kerikun11/micromouse-kerise-v6/README.md

# MicroMouse KERISE v6

けりの第6作目マイクロマウス

## 回路設計

- KiCad

## 機体設計

- Fusion 360

## ソフトウェア開発

- PlatformIO Espressif32 ESP-IDF
