kerikun11/micromouse-kerise-v6/kicad/KERISE.pdf

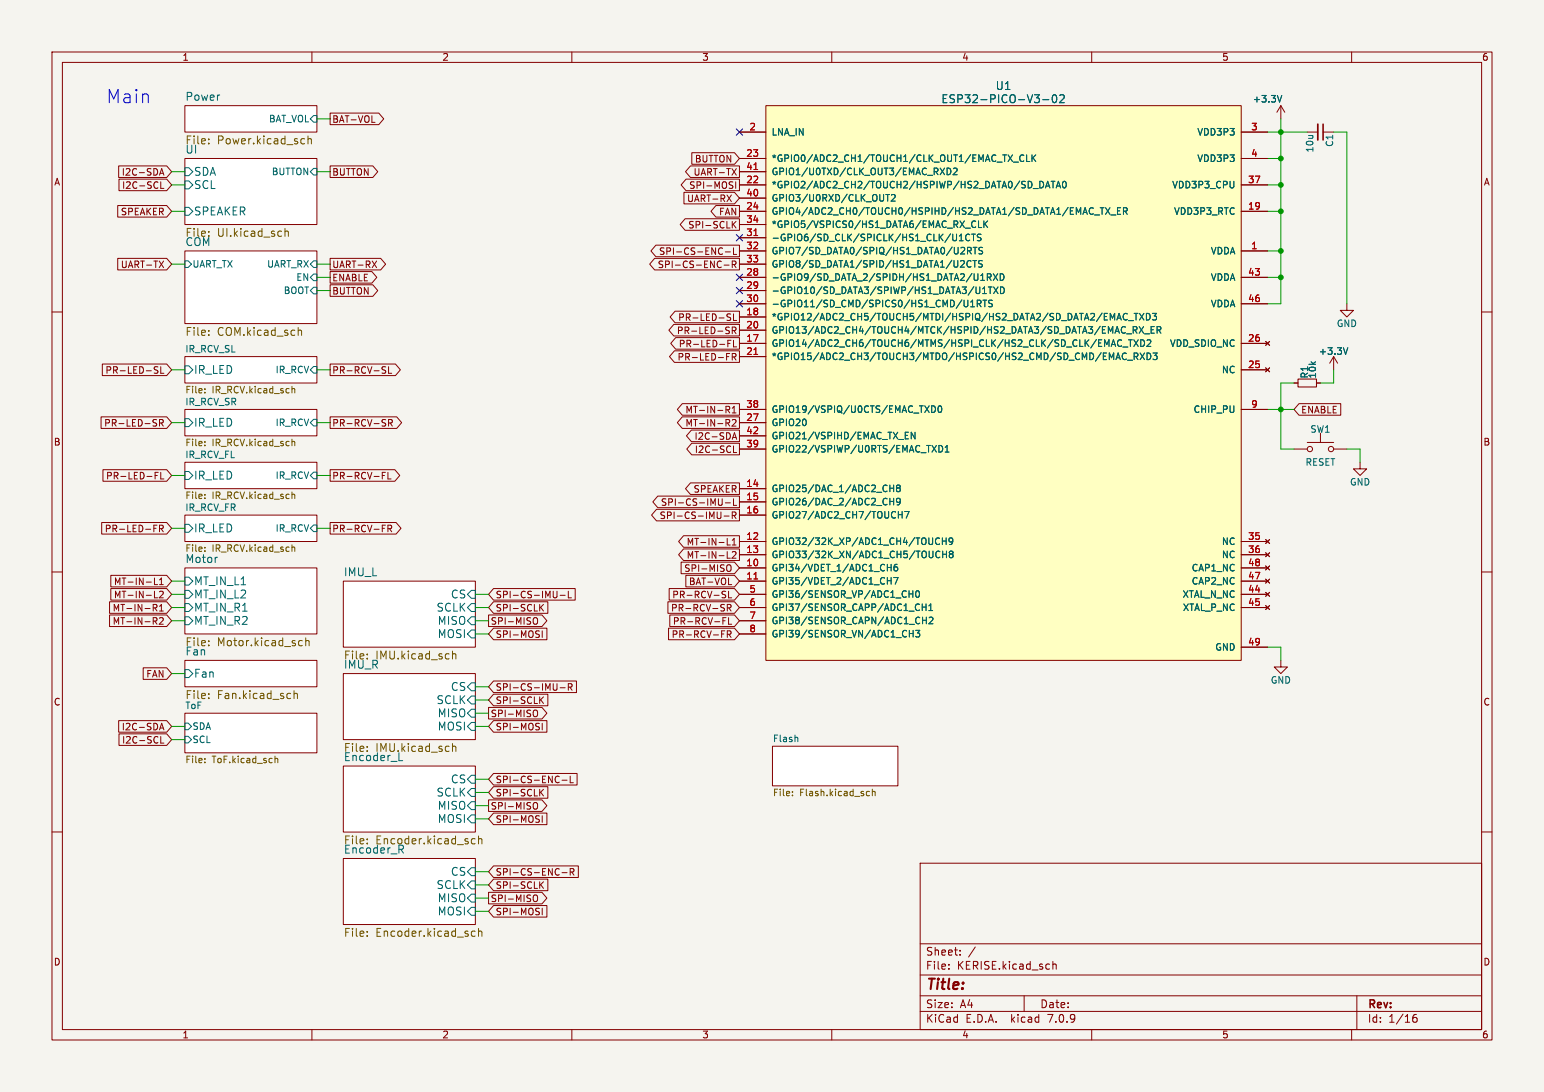
[picture p1: page 1]

PR-RCV-SL PR-RCV-FR MT-IN-R1 UART-RX

SDA UI File: UI.kicad_sch

FAN
PR-RCV-FL PR-LED-SR MT-IN-R2 SPI-CS-IMU-R
PR-LED-FL MT-IN-L2 BAT-VOL MT-IN-L1 SPI-MISO
PR-LED-FR

PR-RCV-FL PR-RCV-SL PR-RCV-SR

PR-LED-SL FAN

SPI-CS-IMU-L SPI-CS-ENC-L SPI-SCLK

MOSI
Flash File: Flash.kicad_sch CS

Id: 1/16 Title: File: KERISE.kicad_sch Sheet: / CS
SCLK
MISO

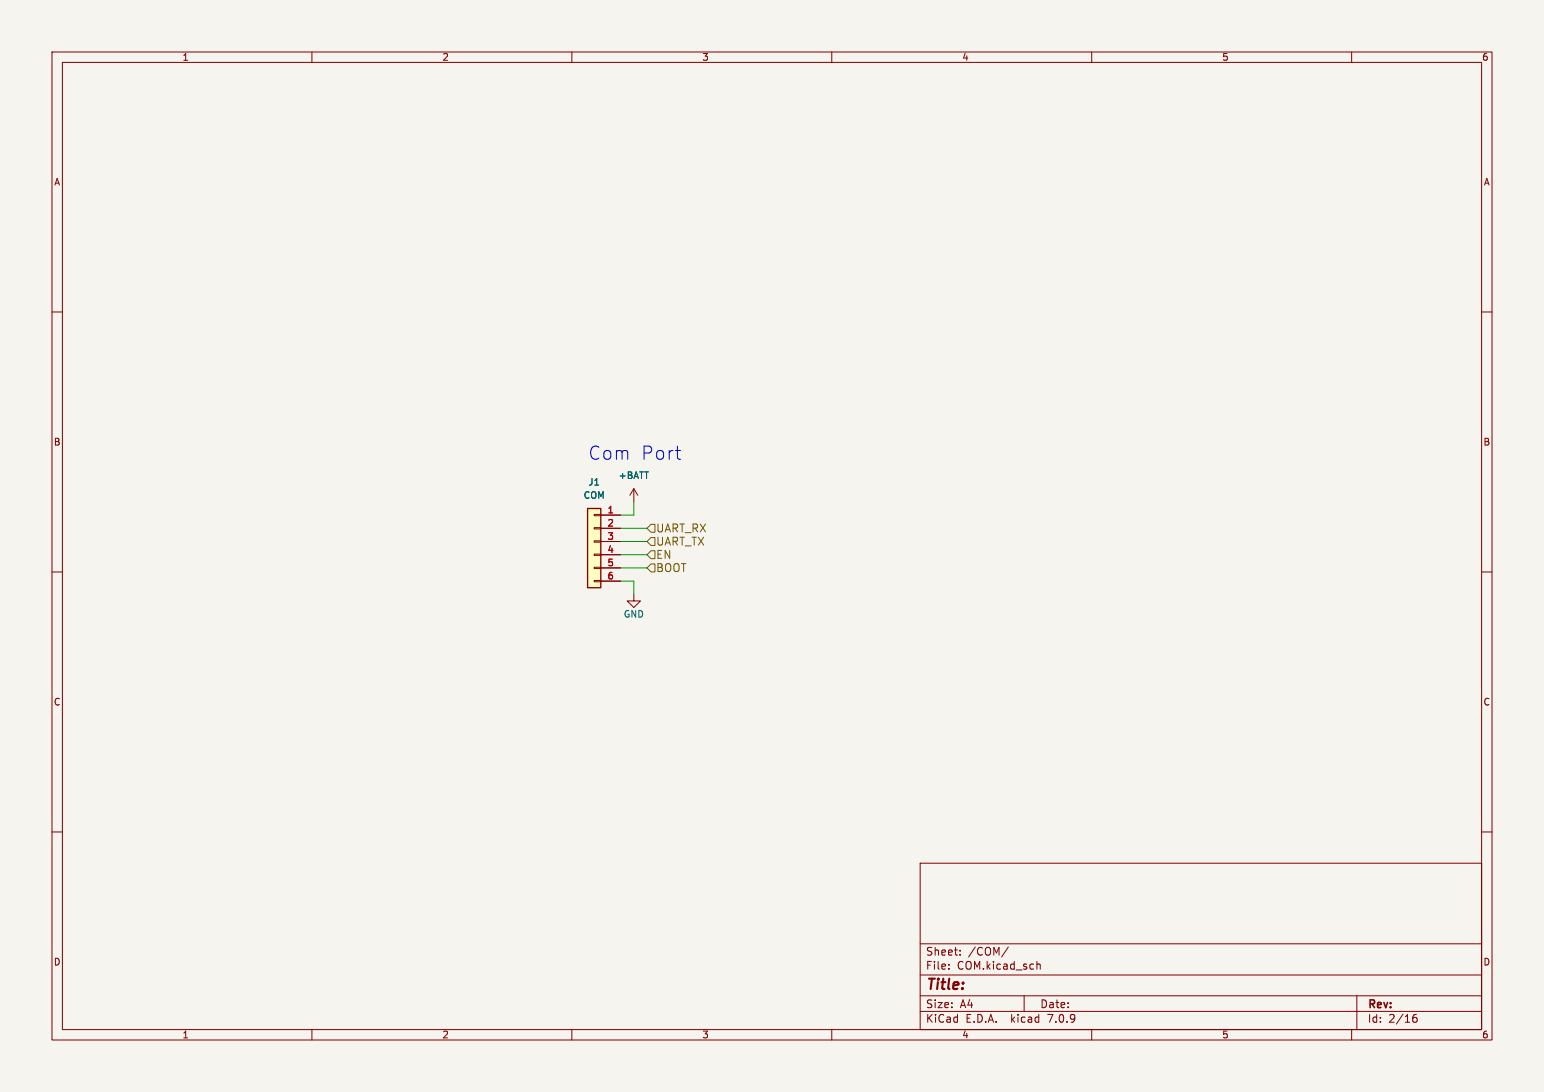
[picture p2: page 2]

Id: 2/16 Title: File: COM.kicad_sch Sheet: /COM/ GND

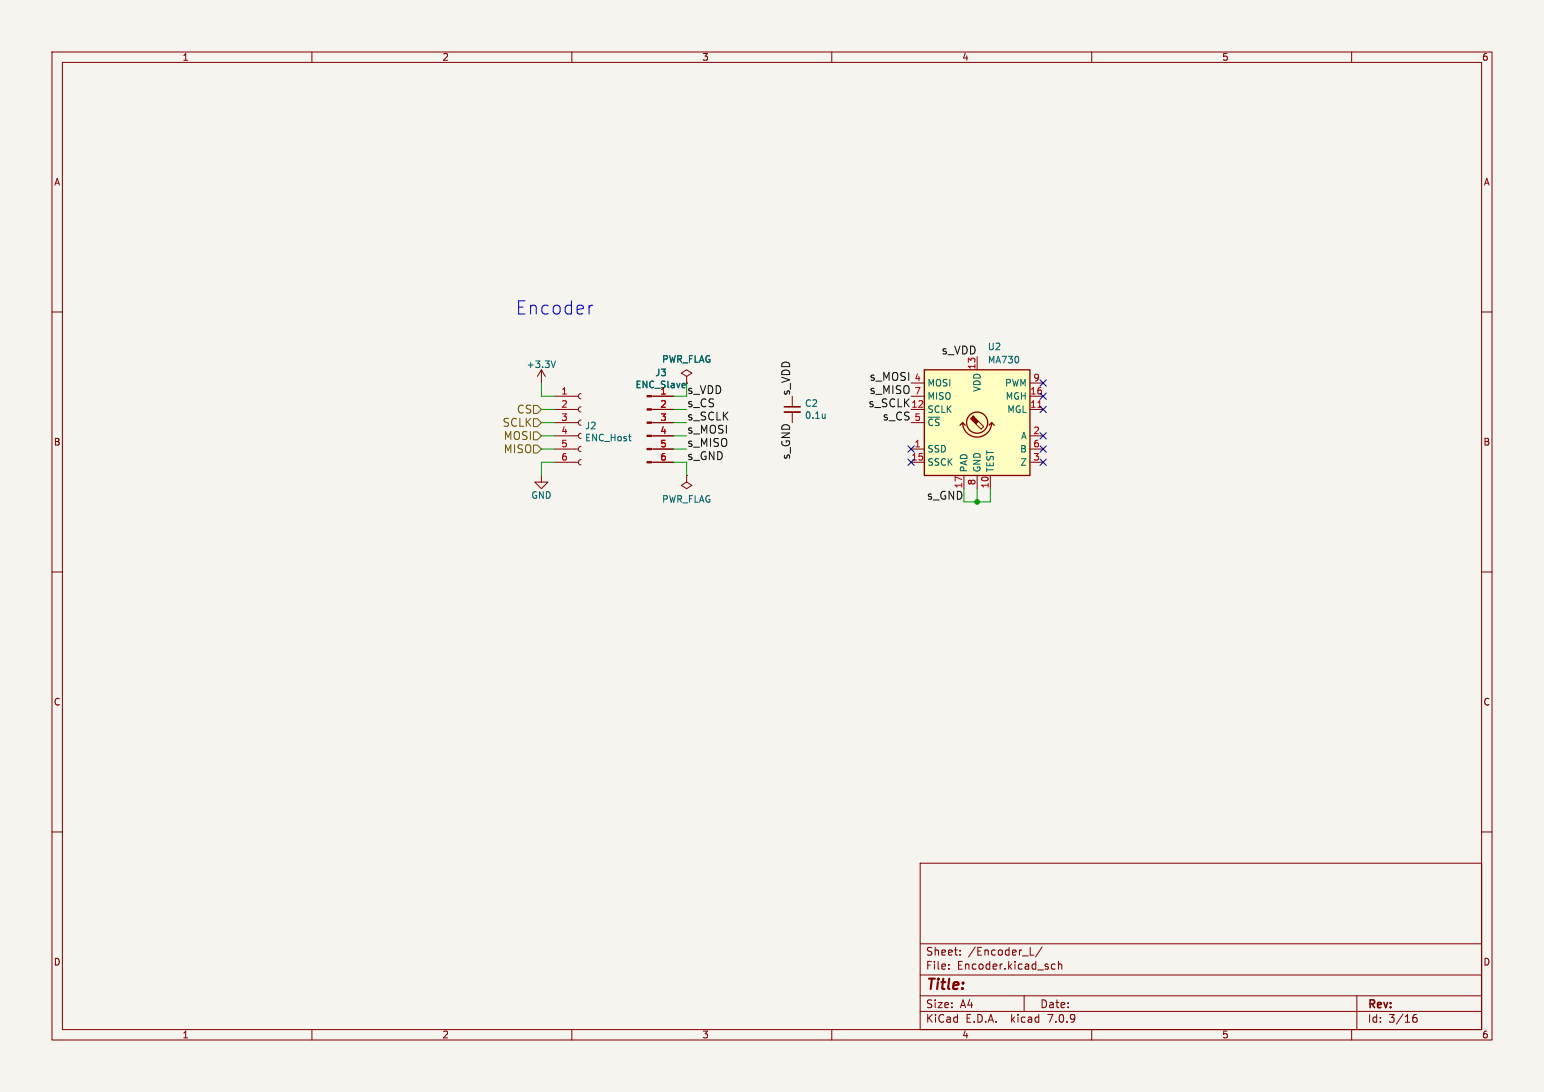
[picture p3: page 3]

Id: 3/16 Title: File: Encoder.kicad_sch Sheet: /Encoder_L/ GND

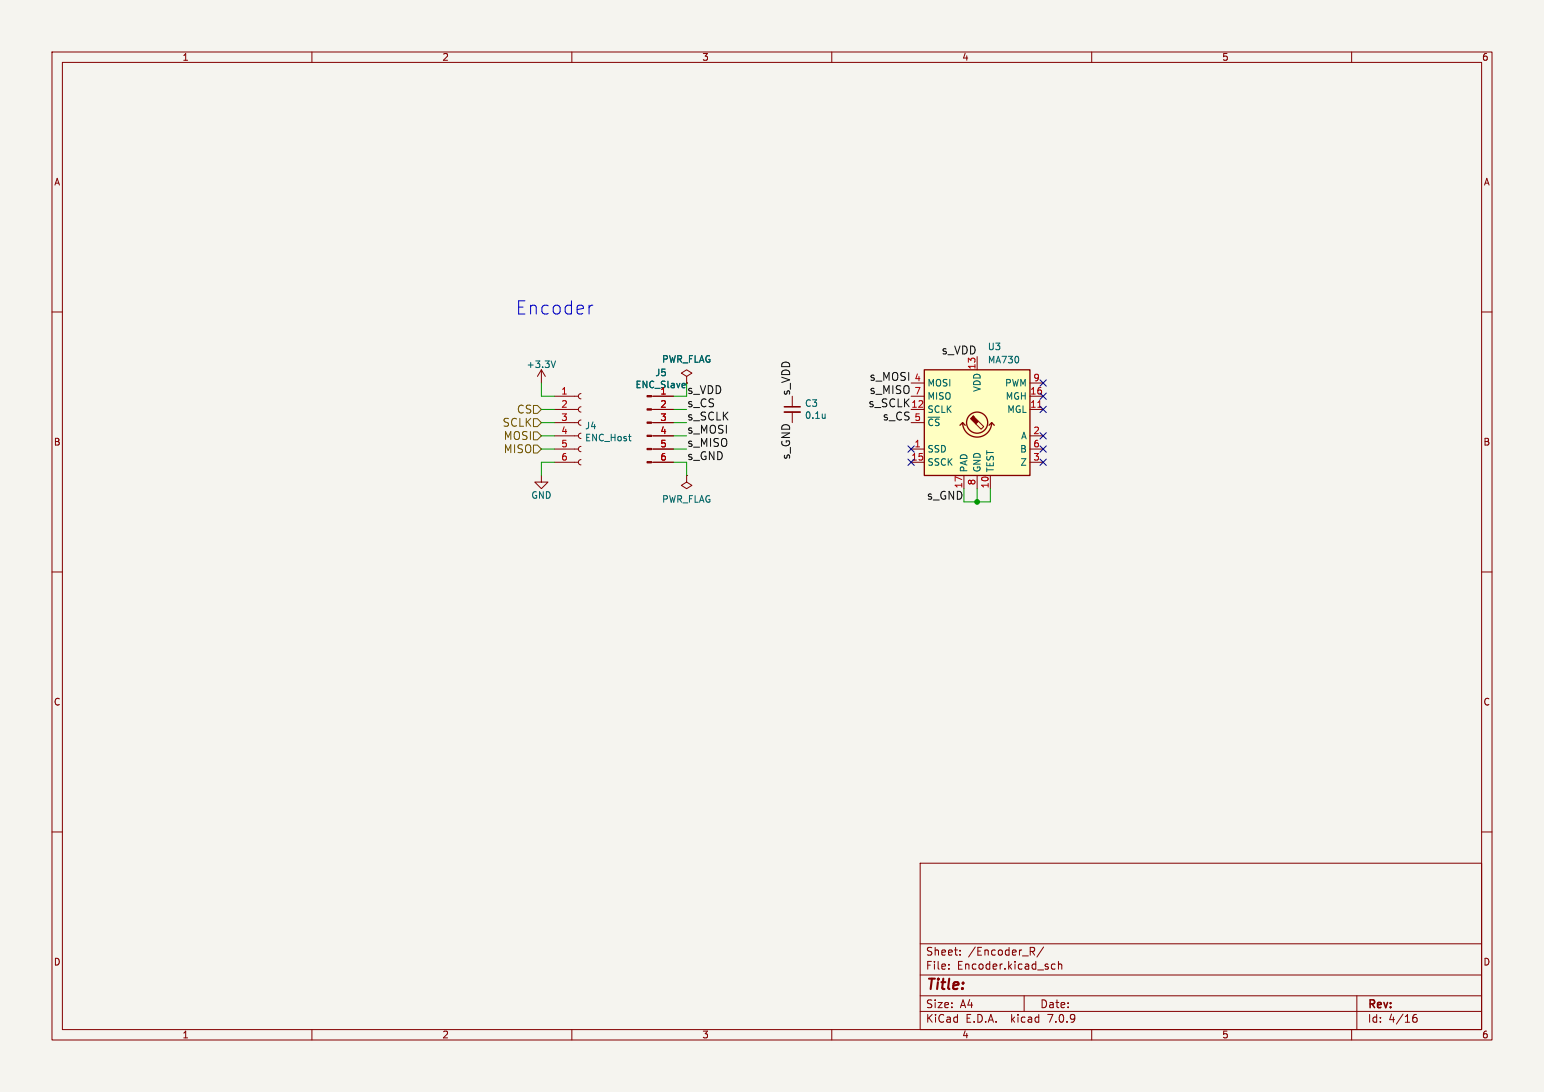
[picture p4: page 4]

Id: 4/16 Title: File: Encoder.kicad_sch Sheet: /Encoder_R/ GND

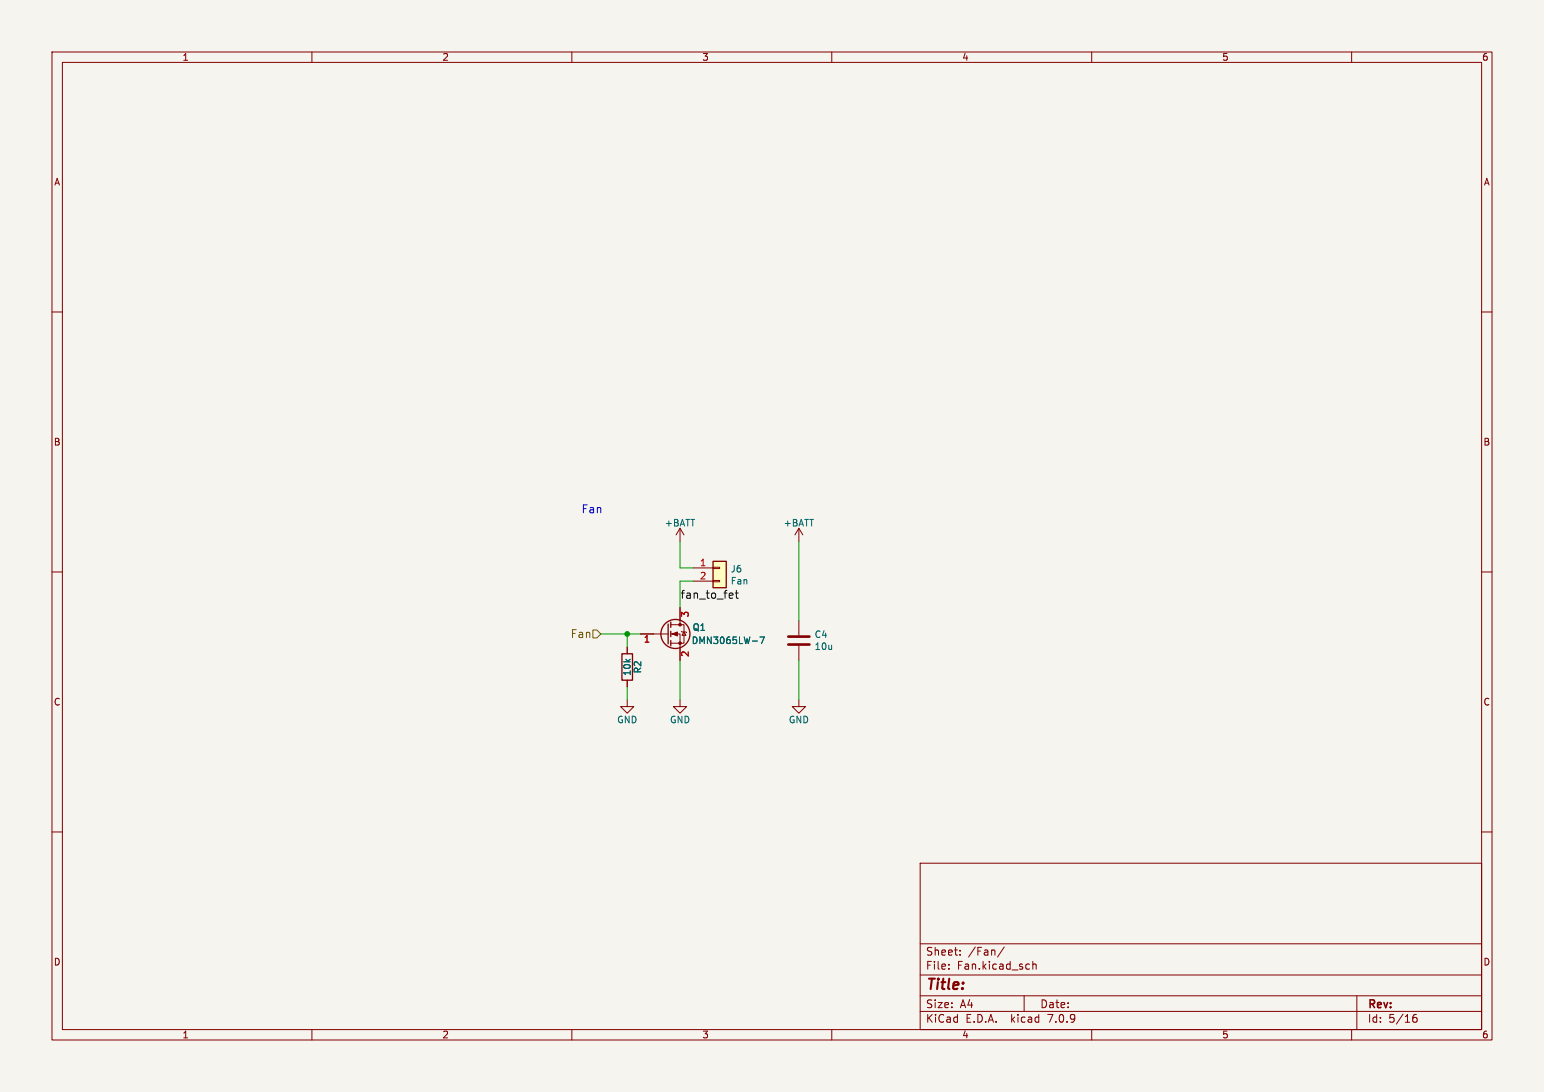
[picture p5: page 5]

2 3 Q1 DMN3065LW-7 C4
Id: 5/16 Title: File: Fan.kicad_sch Sheet: /Fan/ 1

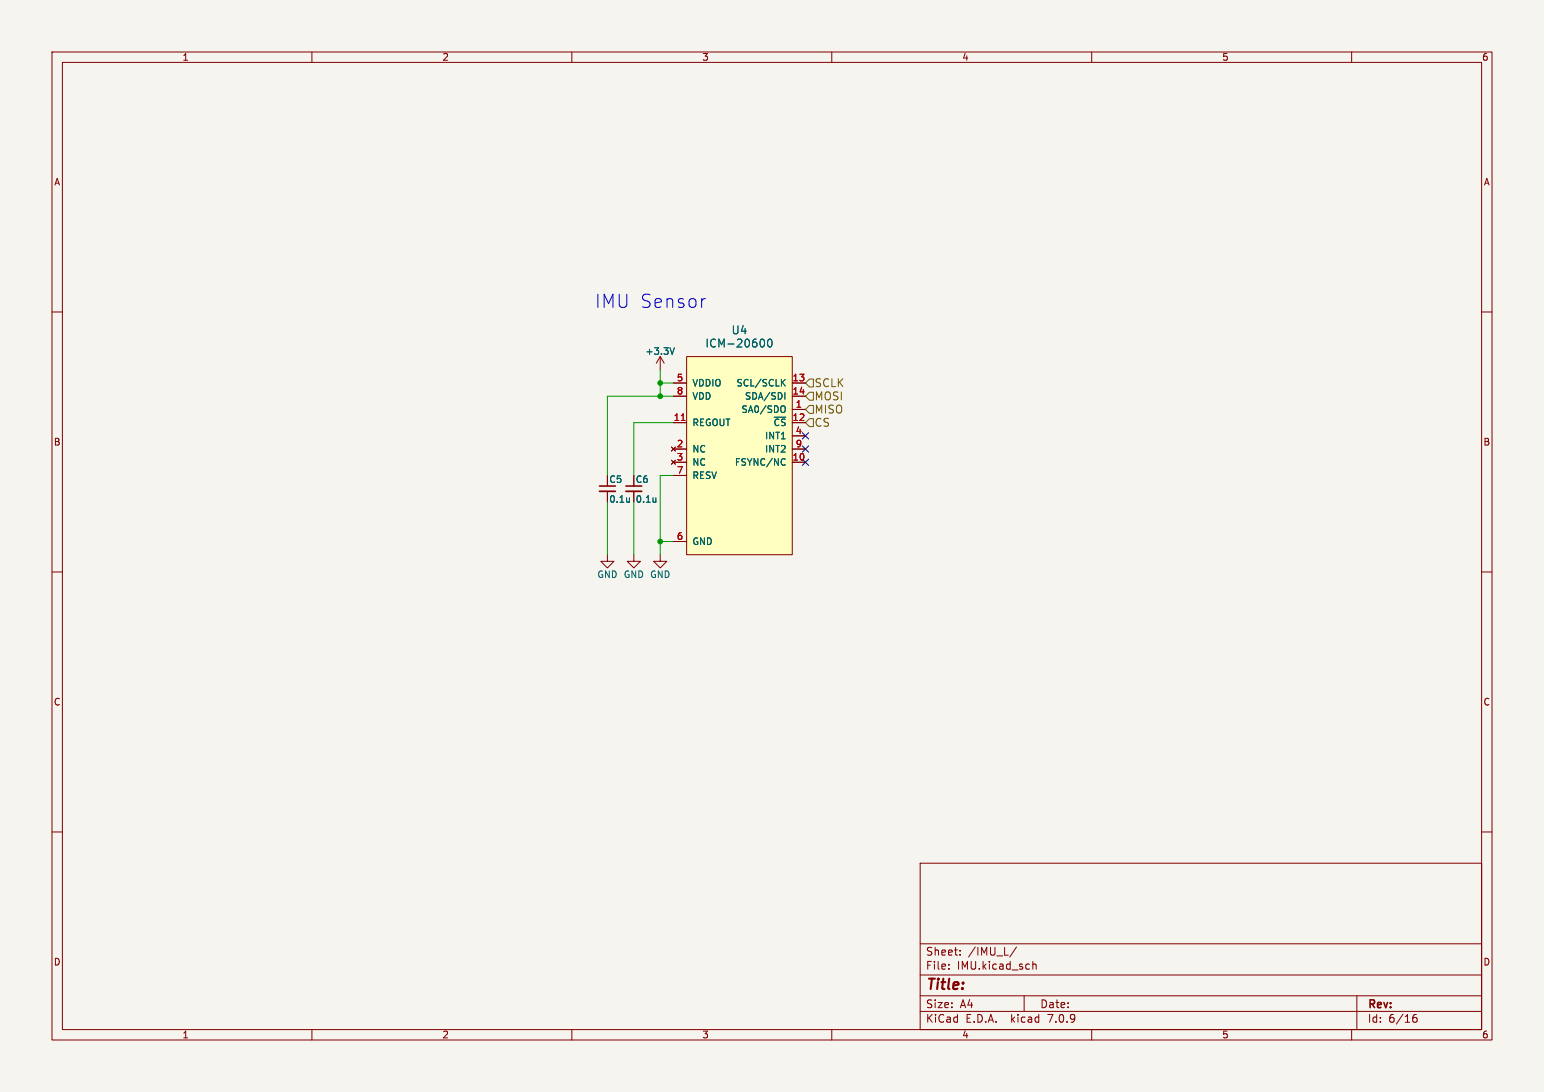
[picture p6: page 6]

Id: 6/16 Title: File: IMU.kicad_sch Sheet: /IMU_L/

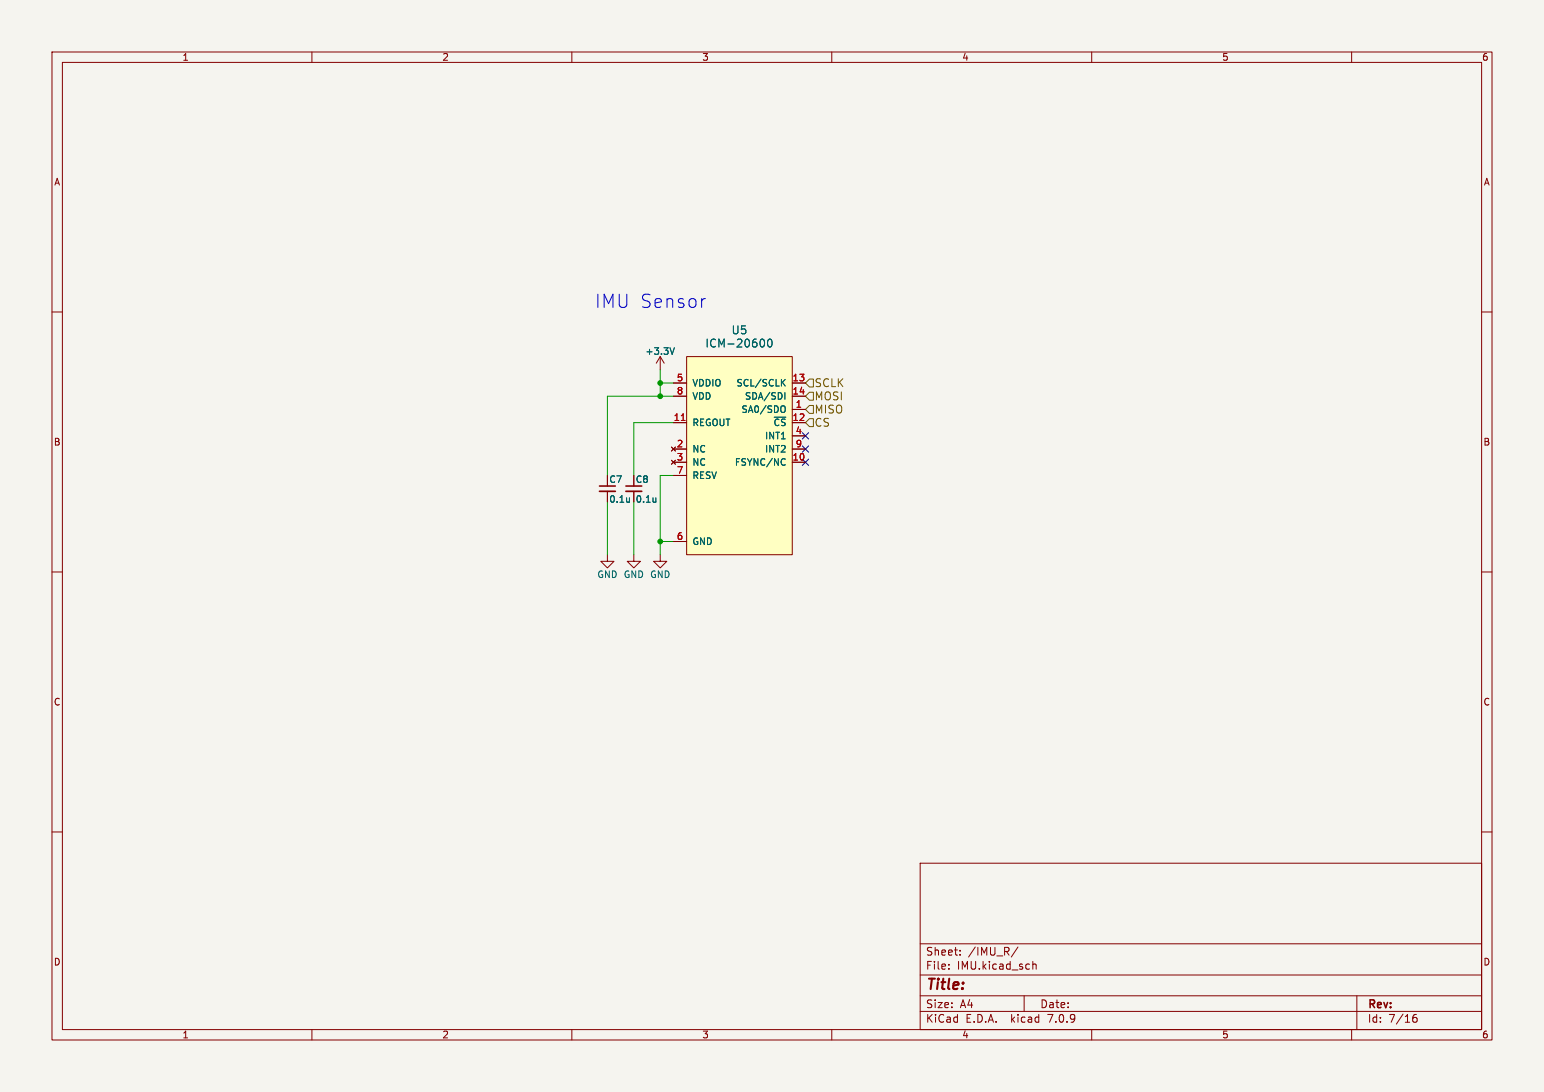
[picture p7: page 7]

Id: 7/16 Title: File: IMU.kicad_sch Sheet: /IMU_R/

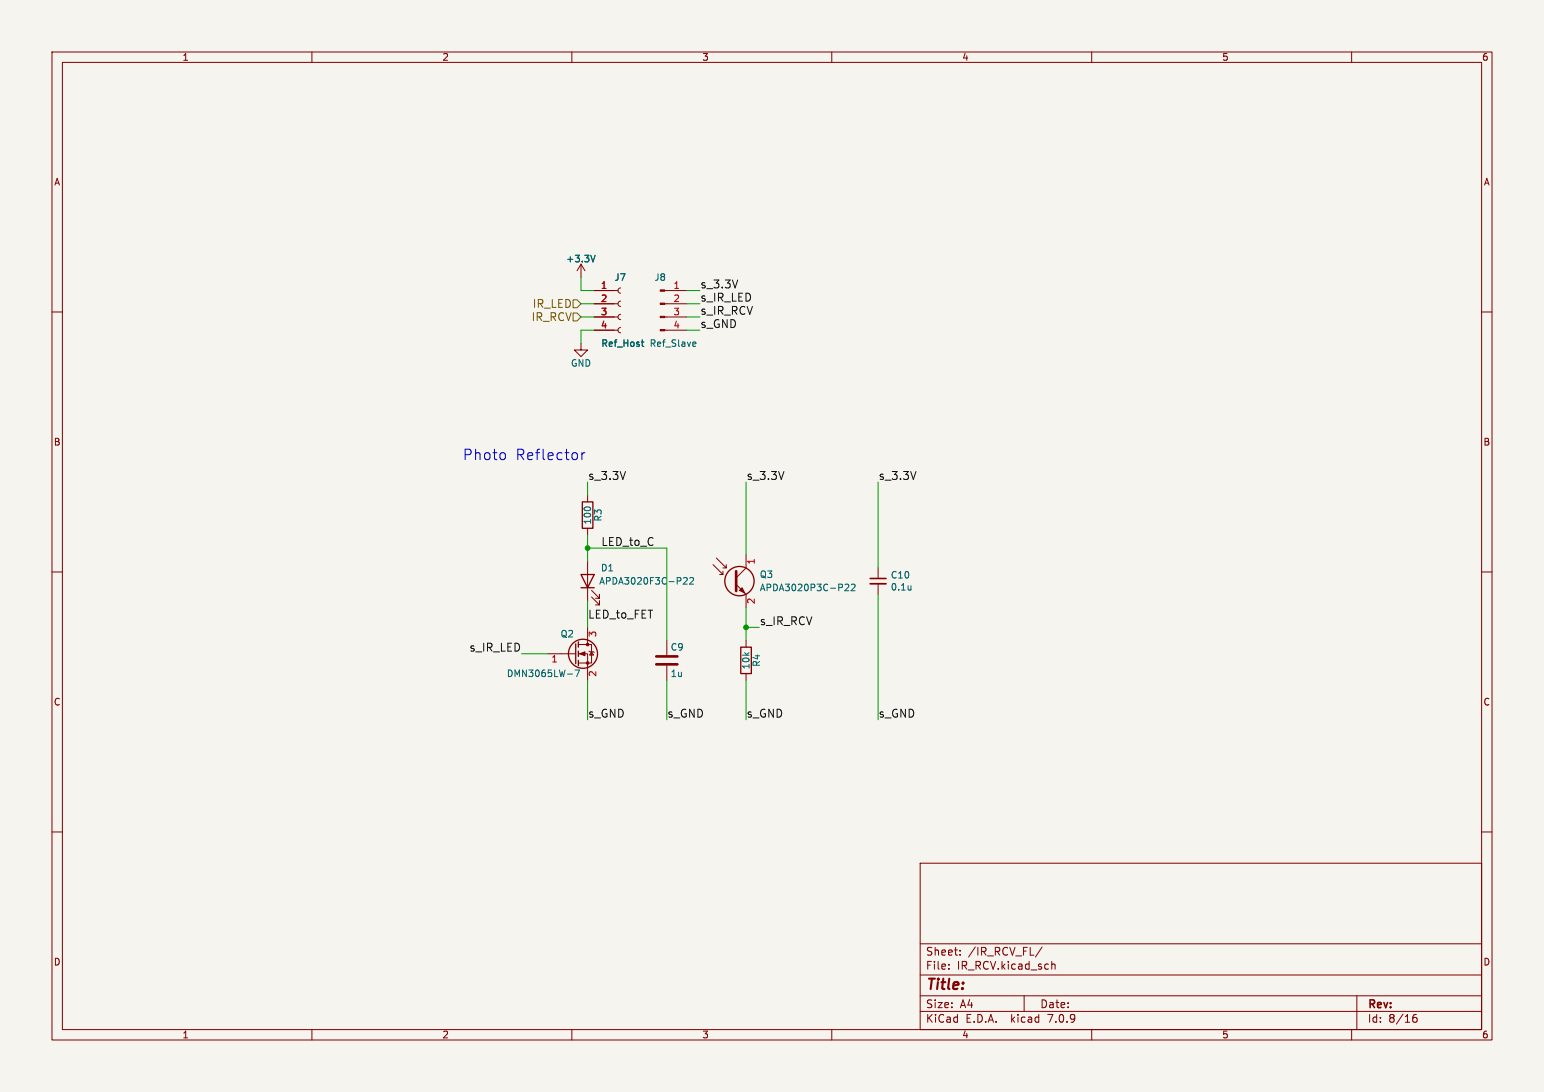
[picture p8: page 8]

Id: 8/16 Title: File: IR_RCV.kicad_sch Sheet: /IR_RCV_FL/ C10

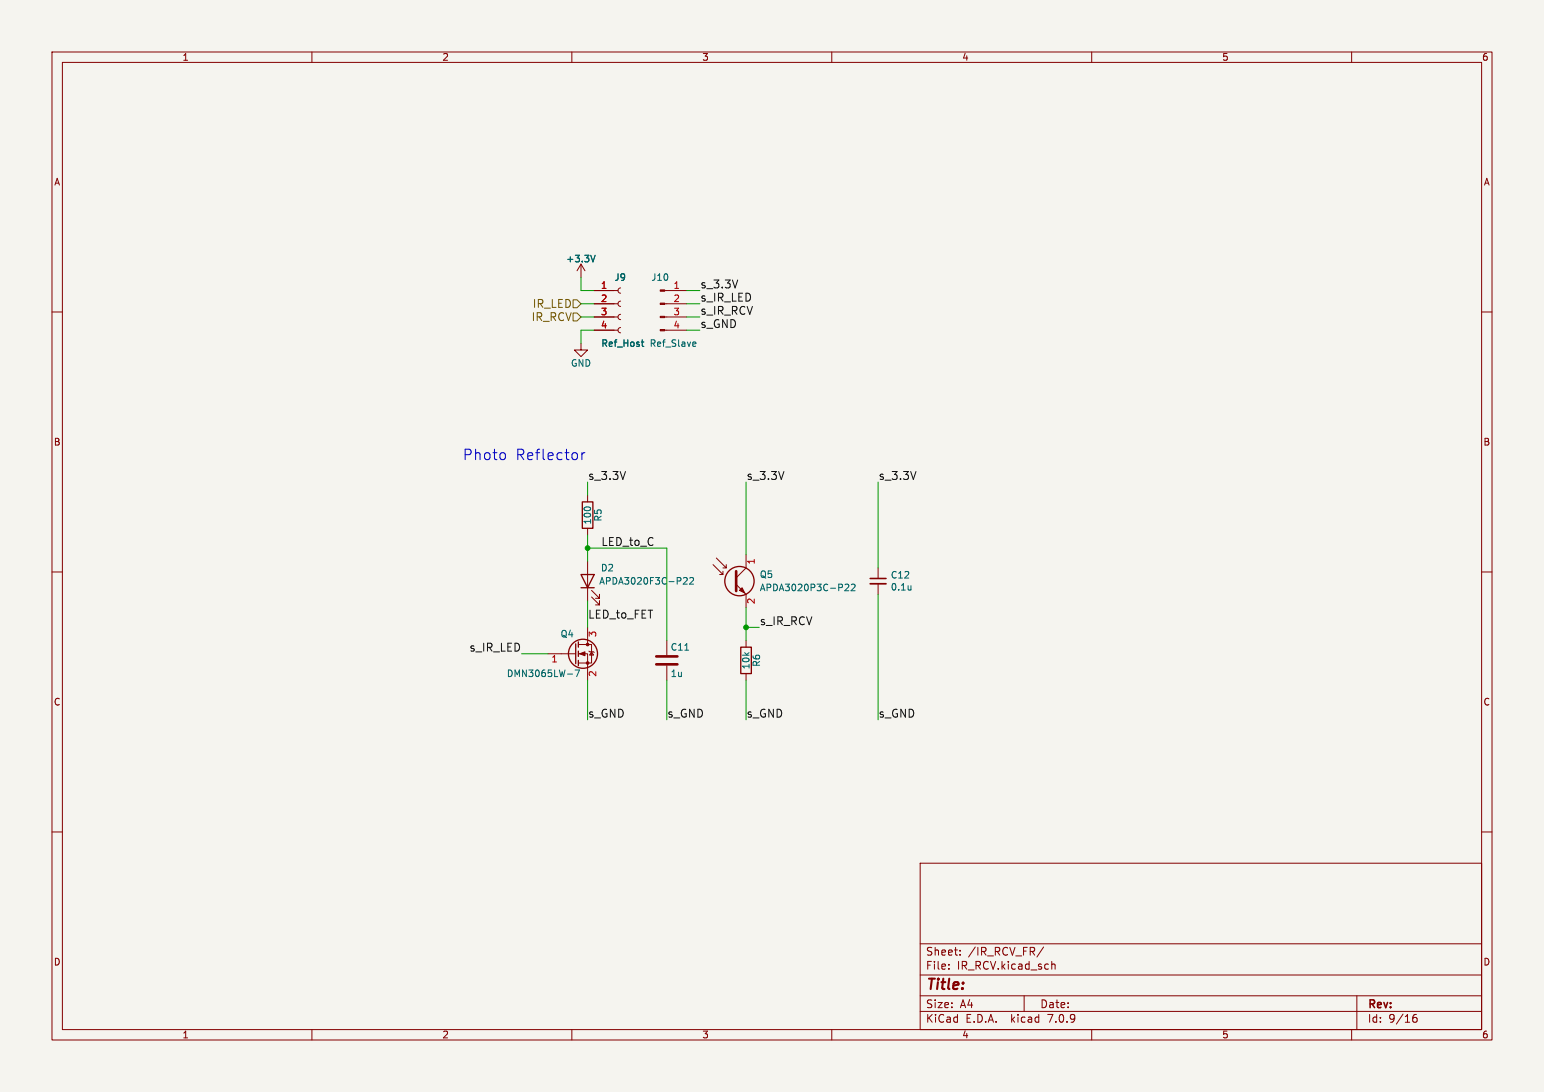
[picture p9: page 9]

Id: 9/16 Title: File: IR_RCV.kicad_sch Sheet: /IR_RCV_FR/ C12

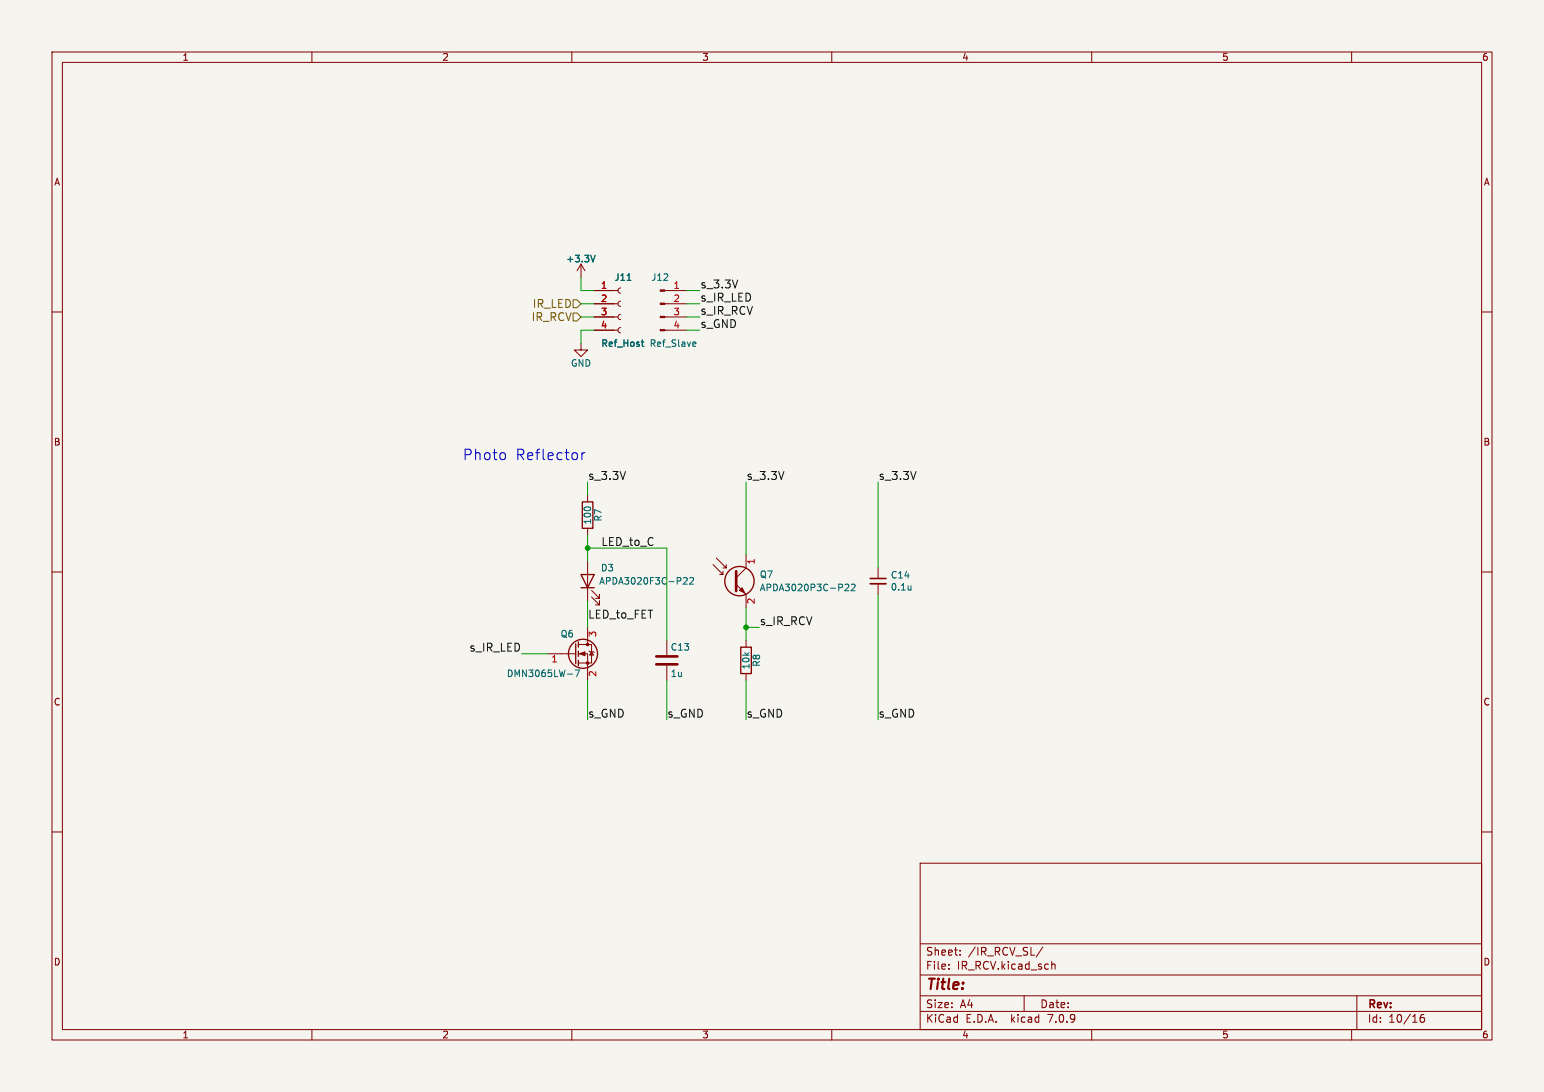
[picture p10: page 10]

Id: 10/16 Title: File: IR_RCV.kicad_sch Sheet: /IR_RCV_SL/ C14

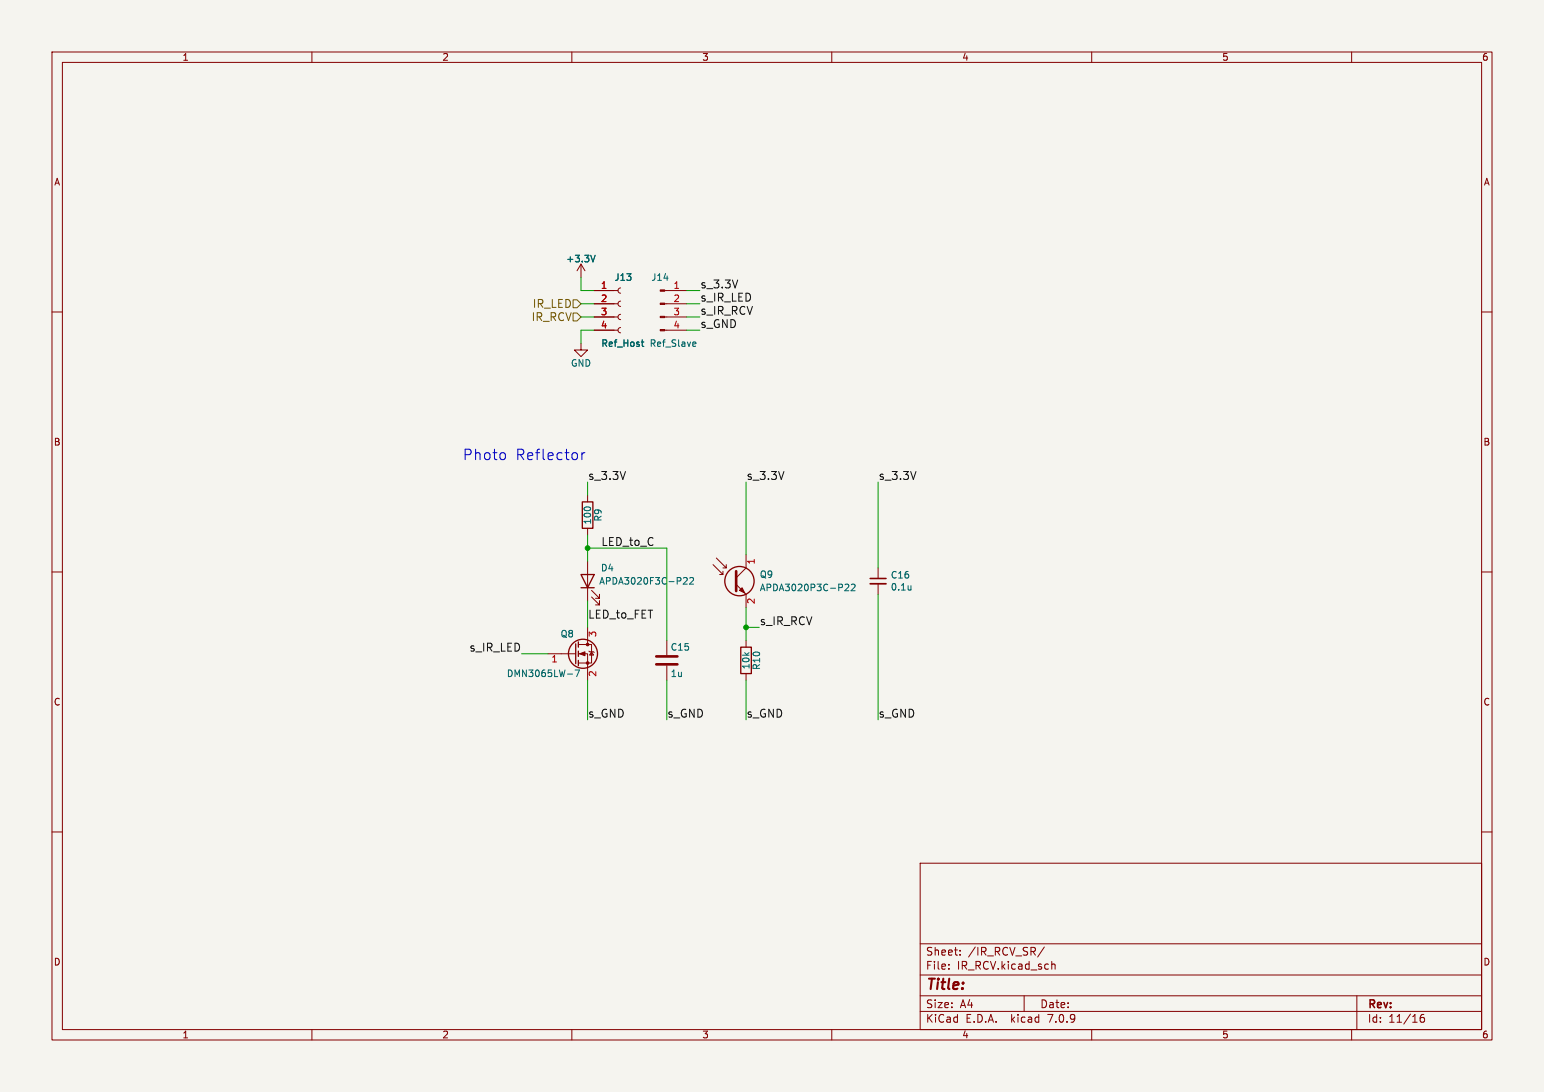
[picture p11: page 11]

Id: 11/16 Title: File: IR_RCV.kicad_sch Sheet: /IR_RCV_SR/ C16

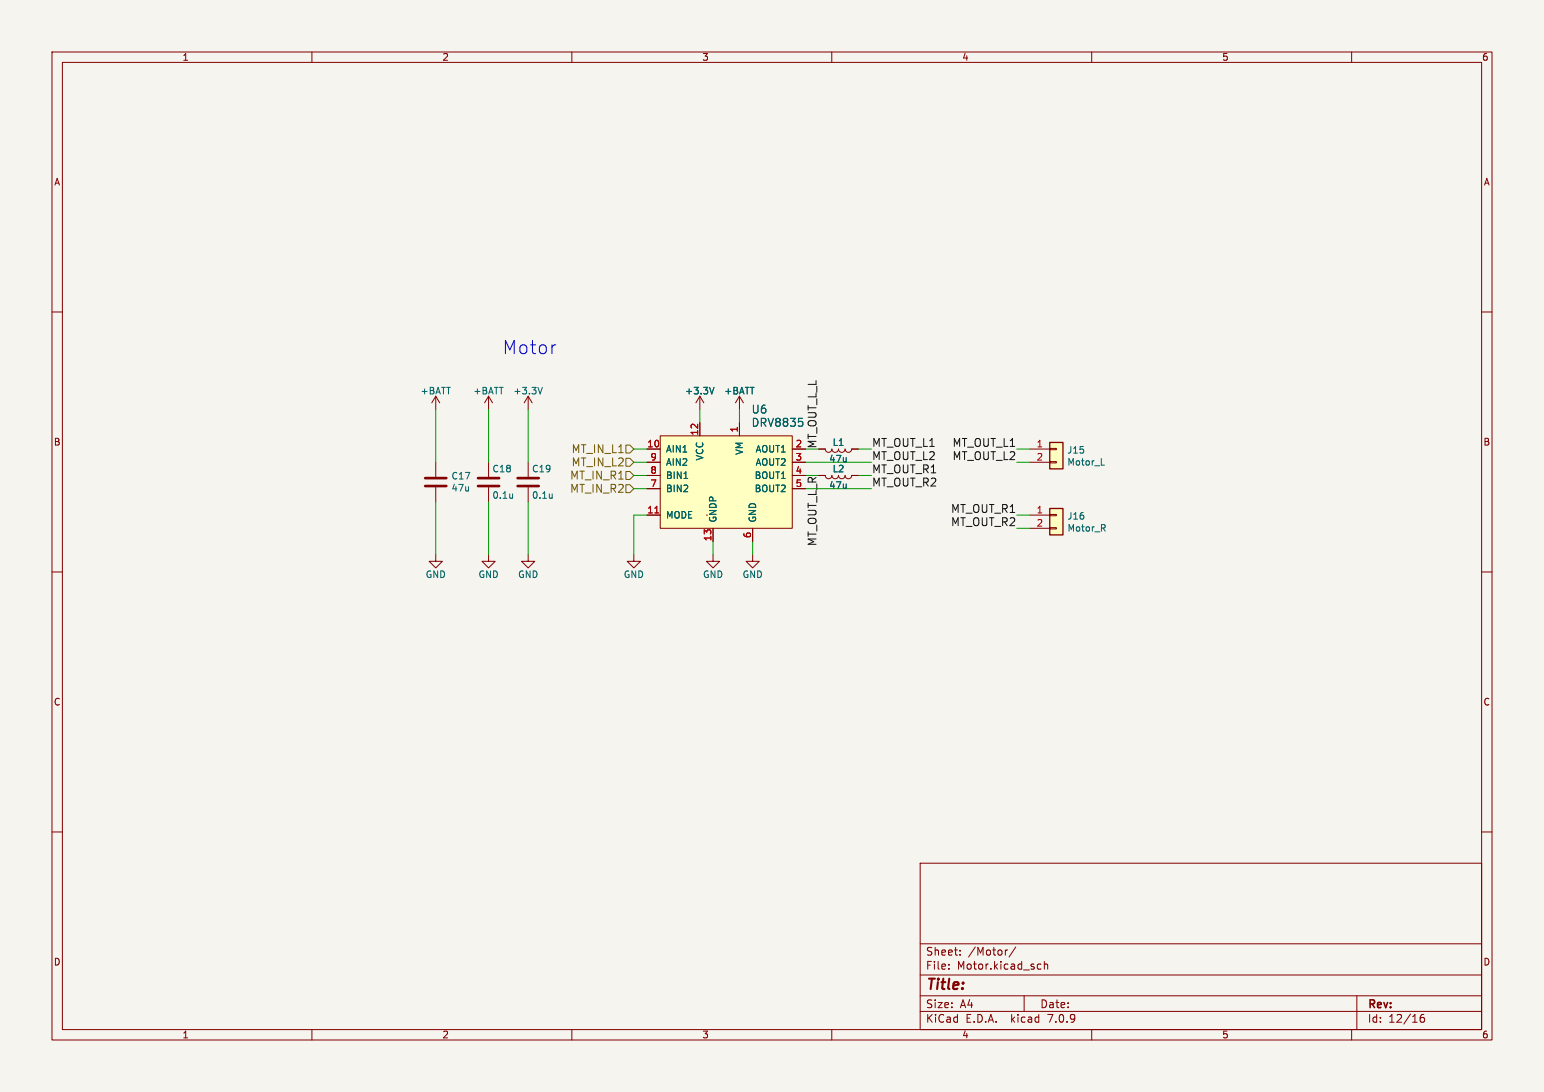
[picture p12: page 12]

1 AIN1 10 MODE 11 VCC 12 GNDP 13 AOUT1 2 AOUT2 3 BOUT1 4 BOUT2 5 GND

Id: 12/16 Title: File: Motor.kicad_sch Sheet: /Motor/ GND

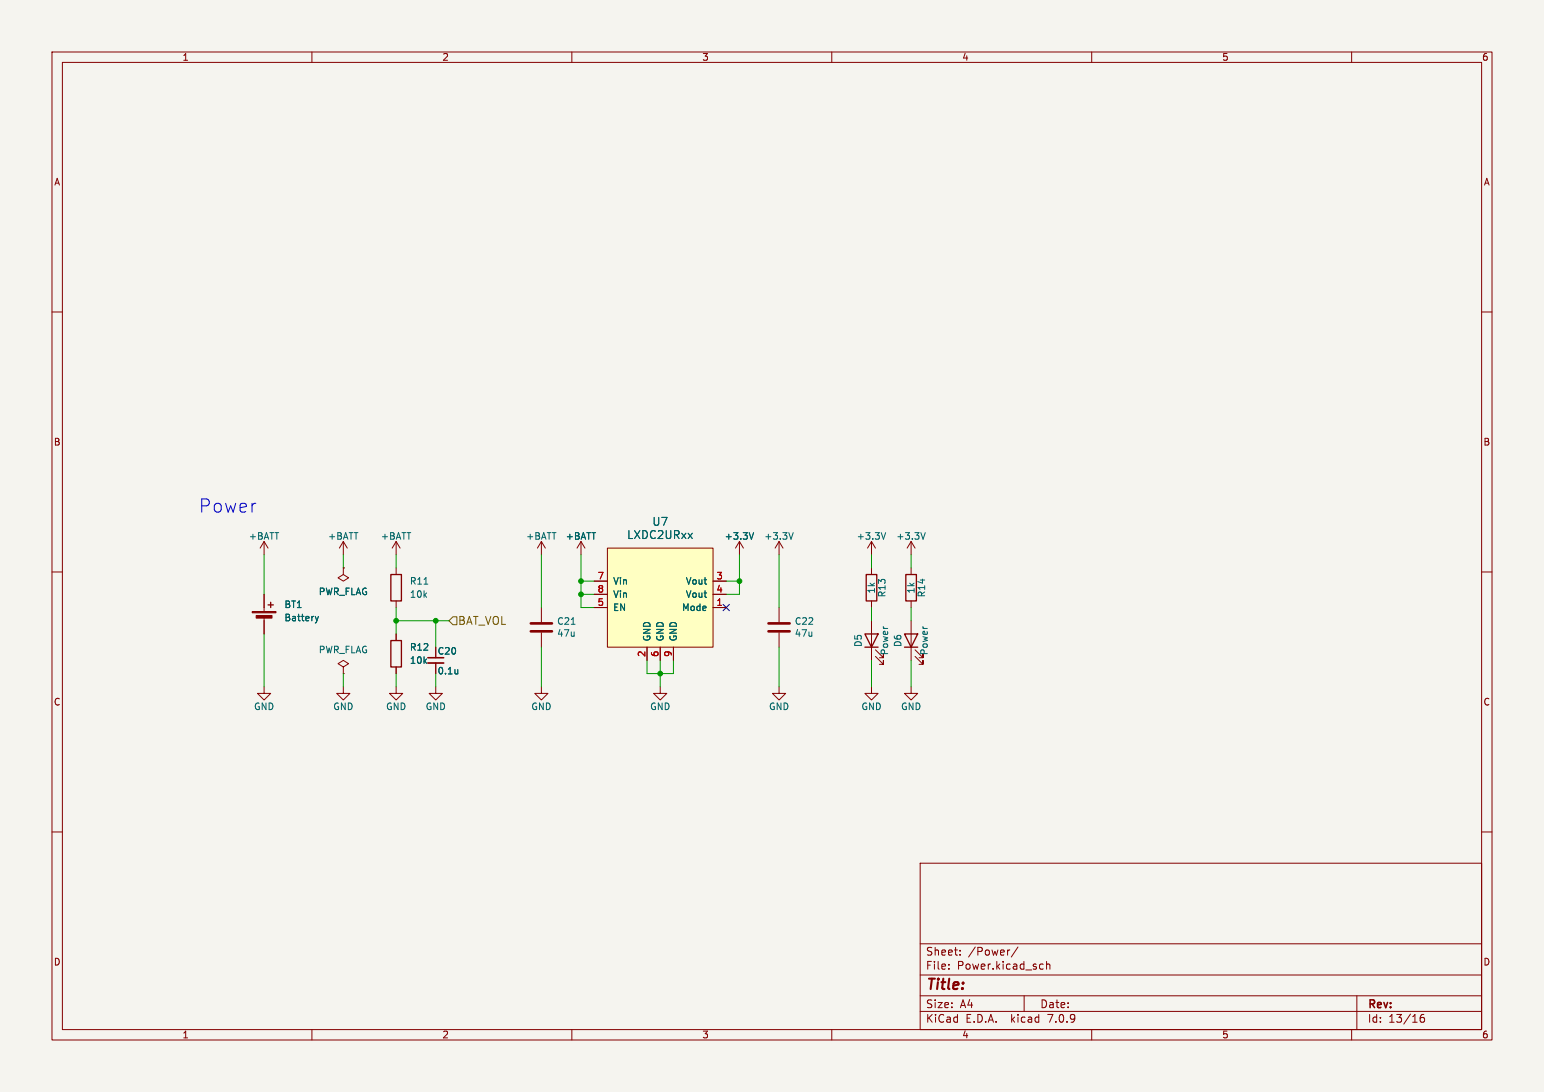
[picture p13: page 13]

2 Vout 3 Vout 4 EN 5 GND

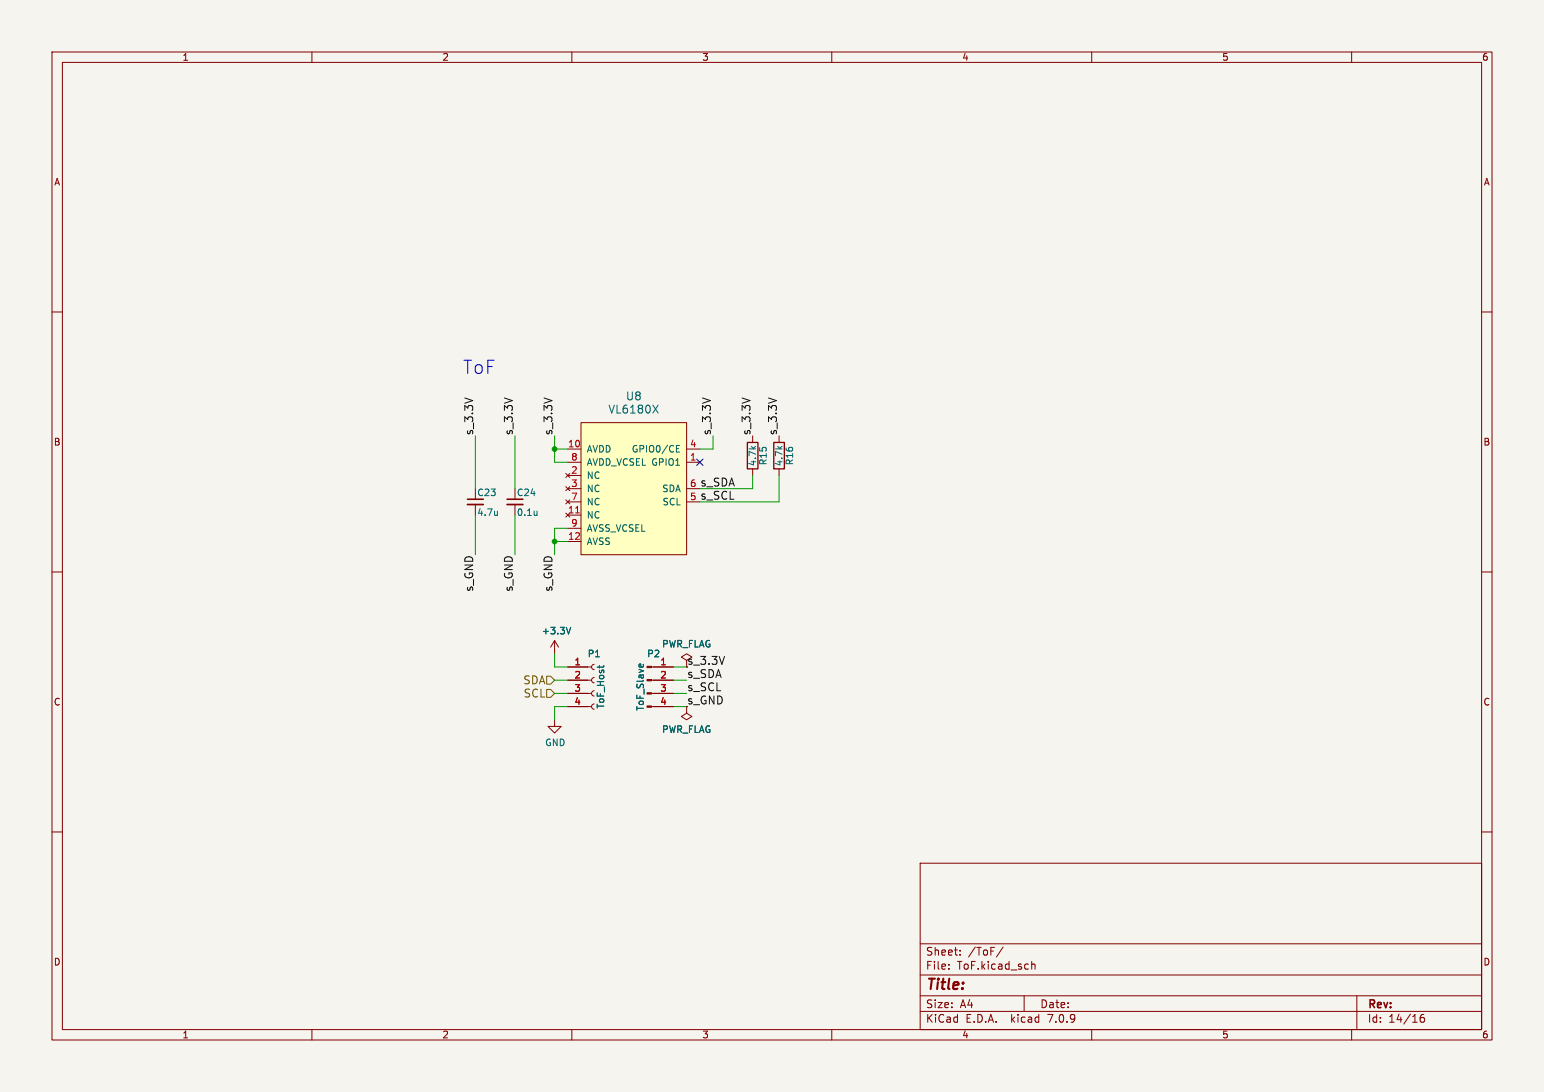
[picture p14: page 14]

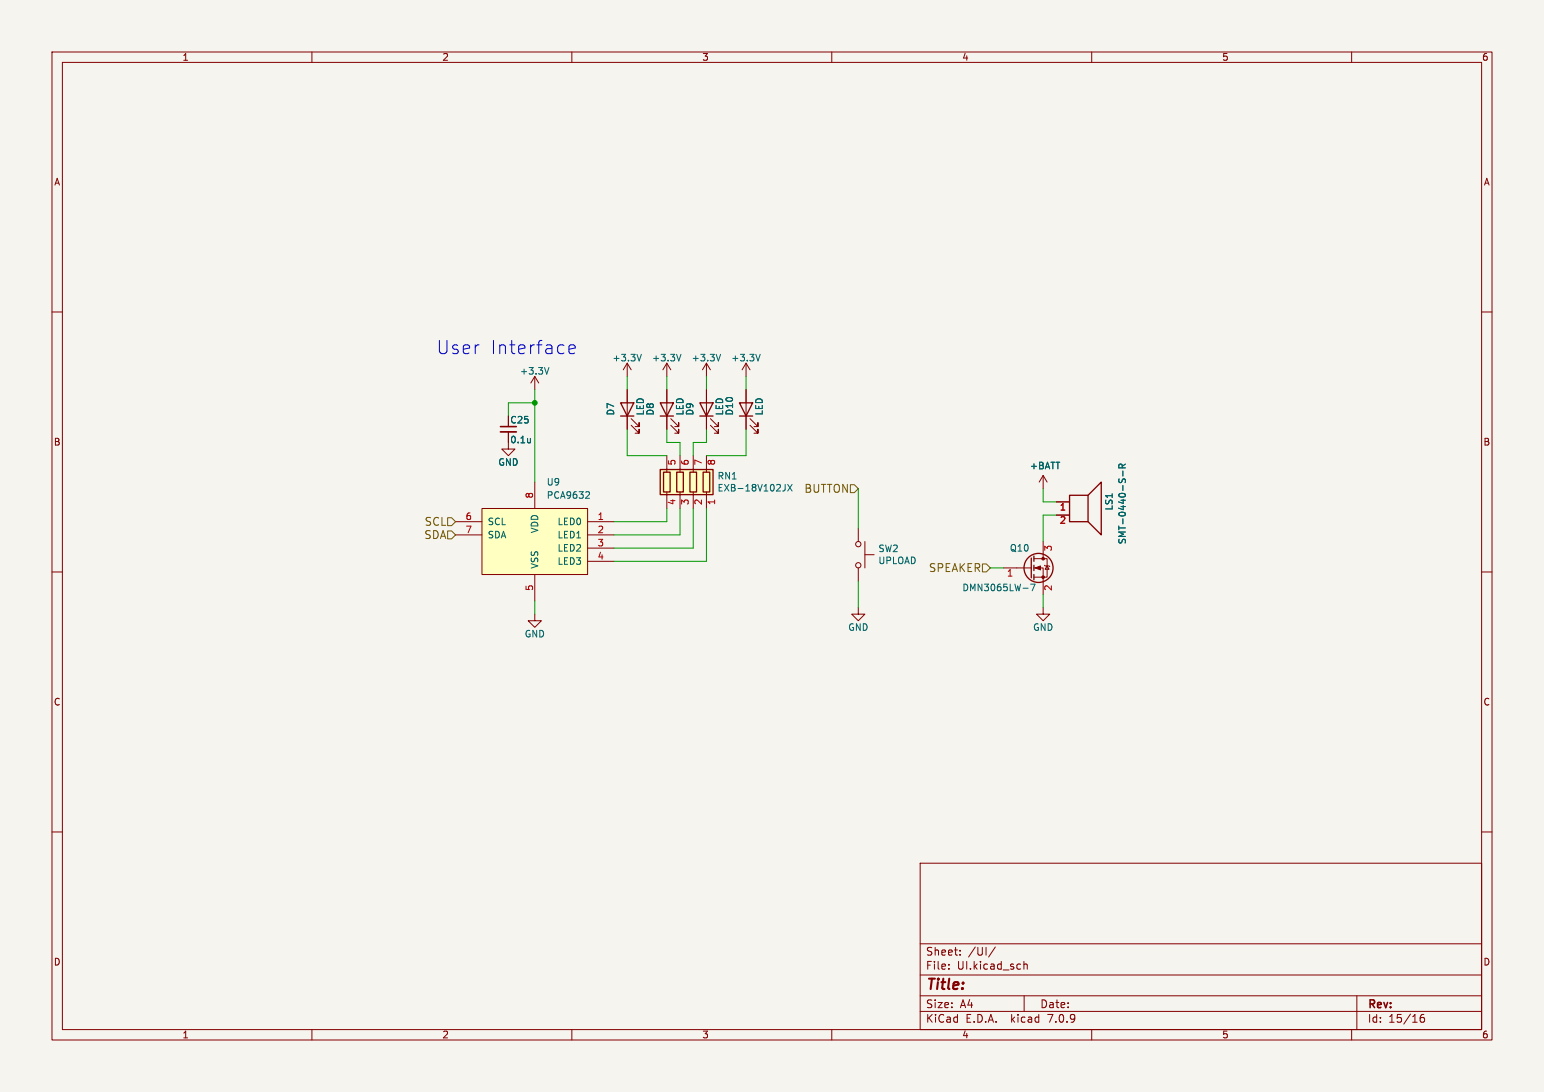
[picture p15: page 15]

0.1uGND
Id: 15/16 Title: File: UI.kicad_sch Sheet: /UI/ GND

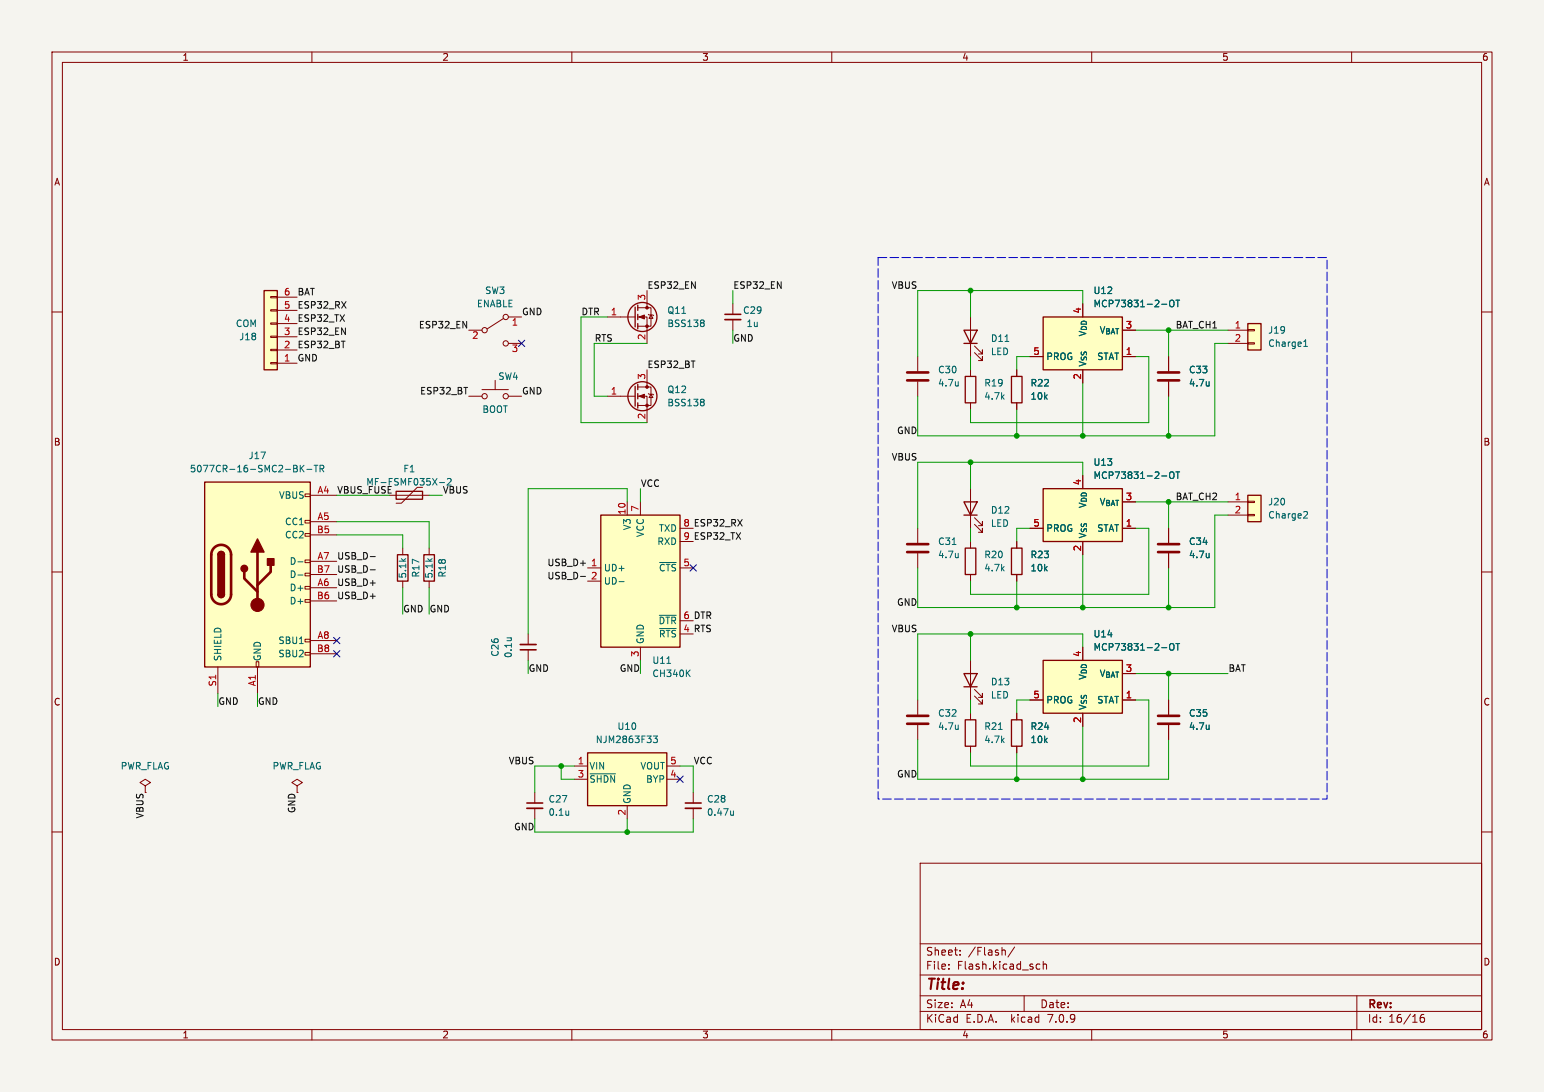
[picture p16: page 16]

2 ~{SHDN} 3 BYP 4 VOUT 5 U10 NJM2863F33 5.1k R17 GND A1 VBUS A4 CC1 A5 D+ A6 D- A7 SBU1 A8 CC2 B5 D+ B6 D- B7 SBU2 B8 SHIELD S1

3 ~{RTS}4 ~{CTS}5 ~{DTR}6 VCC

Id: 16/16 Title: File: Flash.kicad_sch Sheet: /Flash/ C32
