kerikun11/micromouse-kerise-v6/(list of files, drawings)

Other design files:
kicad/freerouting.dsn
kicad/KERISE.dsn
kicad/temp-freerouting.dsn
