kerikun11/micromouse-kerise-v6/kicad/KERISE.kicad_pcb

## KiCad design kicad/KERISE.kicad_pcb (2023-12-30)

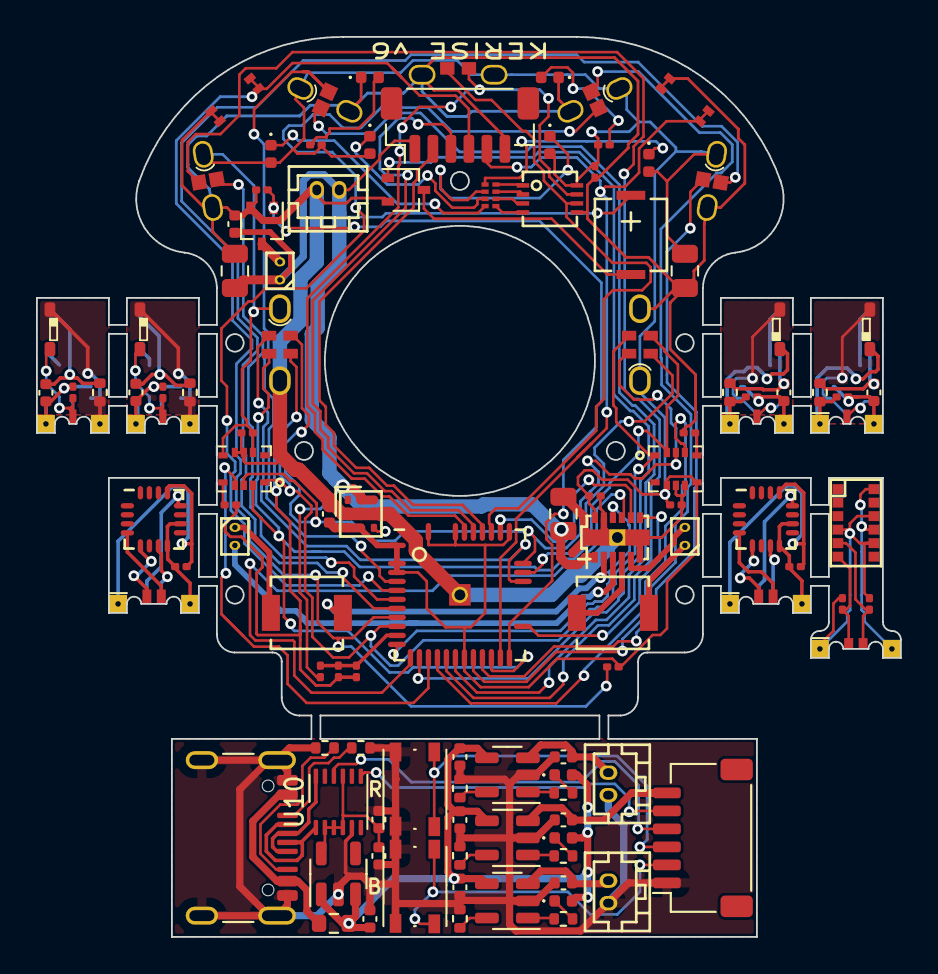
[picture p17: board KERISE.kicad_pcb from above]

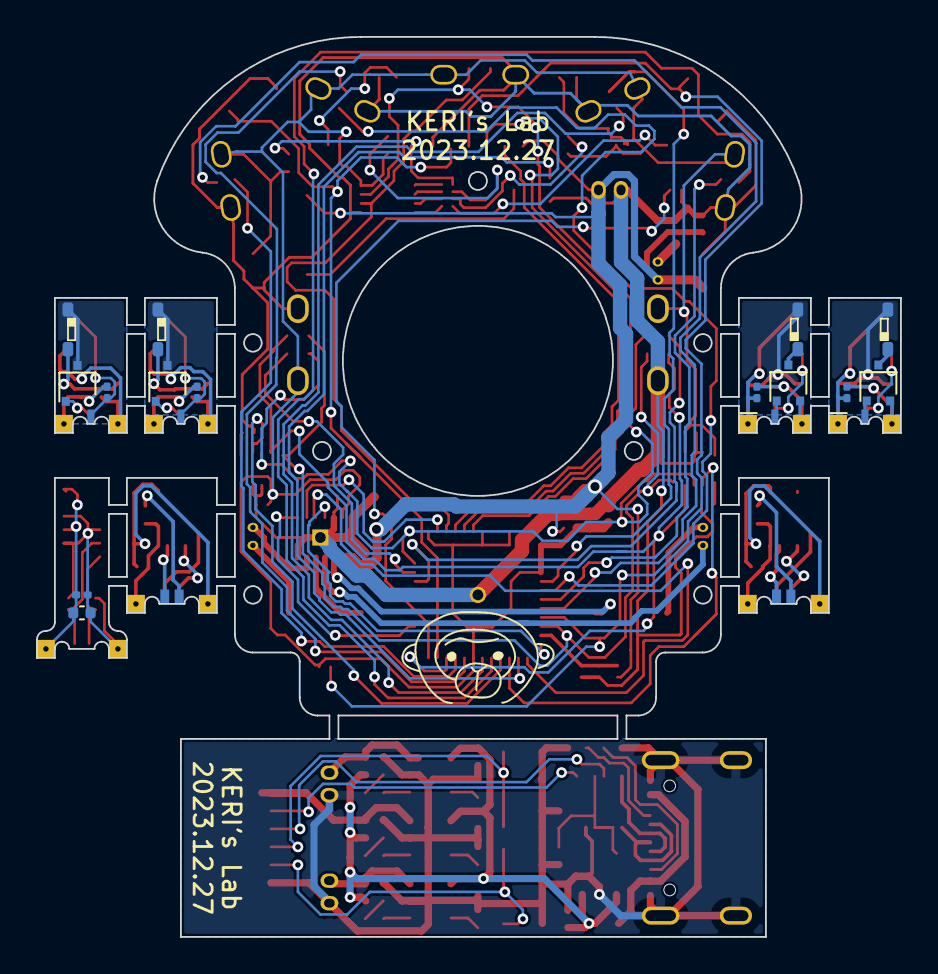
[picture p18: board KERISE.kicad_pcb from below]

Board: 2 copper layers, 48.0 x 50.0 mm, 127 parts (16 on the bottom side), 115 nets.

Parts:
BT1: Battery; Hirose_DF13-02P-1.25DSA_02x1.25mm_Straight
C1, C4: 10u; C_0402_1005Metric
C2, C3, C5, C6, C7, C8, C10, C12, C14, C16, C18, C19, C20, C24, C25: 0.1u; C_0201_0603Metric
C9, C11, C13, C15: 1u; C_0402_1005Metric
C17, C21, C22: 47u; C_0805_2012Metric
C23, C29, C30, C31, C32, C33, C34: 4.7u; C_0402_1005Metric
C26, C27: 0.1u; C_0402_1005Metric
C28: 0.47u; C_0402_1005Metric
D1, D2, D3, D4: APDA3020F3C-P22; APDA3020
D5, D6: Power; LED_0402_1005Metric
D7, D8, D9, D10, D11, D12, D13: LED; LED_0402_1005Metric
F1: MF-FSMF035X-2; R_0603_1608Metric
J1: COM; JST_SH_BM06B-SRSS-TB_1x06-1MP_P1.00mm_Vertical
J2, J4: ENC_Host; STAND_HOST_06
J3, J5: ENC_Slave; STAND_SLAVE_06
J6: Fan; SMD_conn_2
J7, J9, J11, J13: Ref_Host; IR_HOST_V_04
J8, J10, J12, J14: Ref_Slave; IR_SLAVE_V_04
J15: Motor_L; SMD_conn_2
J16: Motor_R; SMD_conn_2
J17: COM; JST_SH_SM06B-SRSS-TB_1x06-1MP_P1.00mm_Horizontal
J18: 5077CR-16-SMC2-BK-TR; USB_C_Receptacle_GCT_USB4105-xx-A_16P_TopMnt_Horizontal
J19: Charge1; Hirose_DF13-02P-1.25DSA_02x1.25mm_Straight
J20: Charge2; Hirose_DF13-02P-1.25DSA_02x1.25mm_Straight
L1, L2: 47u; L_4018
LS1: SMT-0440-S-R
P1: ToF_Host; STAND_HOST_04
P2: ToF_Slave; STAND_SLAVE_04
Q1, Q2, Q4, Q6, Q8, Q10: DMN3065LW-7; SOT-323_SC-70
Q3, Q5, Q7, Q9: APDA3020P3C-P22; APDA3020
R1, R2, R4, R6, R8, R10, R11, R12: 10k; R_0201_0603Metric
R3, R5, R7, R9: 100; R_0402_1005Metric
R13, R14: 1k; R_0201_0603Metric
R15, R16: 4.7k; R_0201_0603Metric
R17, R18: 5.1k; R_0402_1005Metric
R19, R20, R21: 1k; R_0402_1005Metric
R22, R23, R24: 10k; R_0402_1005Metric
RN1: EXB-18V102JX; R_Array_Concave_4x0201
SW1: RESET; EVPBB
SW2: UPLOAD; EVPBB
SW3: RESET; SW_Push_1P1T_NO_Vertical_Wuerth_434133025816
SW4: BOOT; SW_Push_1P1T_NO_Vertical_Wuerth_434133025816
U1: ESP32-PICO-V3-02
U2, U3: MA730
U4, U5: ICM-20600
U6: DRV8835
U7: LXDC2URxx; LXDC2UR
U8: VL6180X
U9: PCA9632; DFN-8-1EP_3x3mm_Pitch0.5mm
U10: FT234XD; DFN-12-1EP_3x3mm_P0.5mm_EP1.6x2.5mm
U11: NJM2863F33; TSOT-23-5
U12, U13, U14: MCP73831-2-OT; SOT-23-5

Connections:
+3.3V: C1.2, C5.1, C7.1, C19.1, C22.1, C25.1, D7.2 (A), D8.2 (A), D9.2 (A), D10.2 (A), J2.1, J4.1, J7.1, J9.1, J11.1, J13.1, P1.1, R1.2, R13.1, R14.1, U1.1 (VDDA), U1.3 (VDD3P3), U1.4 (VDD3P3), U1.19 (VDD3P3_RTC), U1.37 (VDD3P3_CPU), U1.43 (VDDA), U1.46 (VDDA), U4.5 (VDDIO), U4.8 (VDD), U5.5 (VDDIO), U5.8 (VDD), U6.12 (VCC), U7.3 (Vout), U7.4 (Vout), U9.8 (VDD)
+BATT: BT1.1 (+), C4.1, C17.1, C18.1, C21.1, J1.1, J6.1, LS1.1, R11.1, U6.1 (VM), U7.5 (EN), U7.7 (Vin), U7.8 (Vin)
/Encoder_L/s_CS: J3.2, U2.5 (~CS)
/Encoder_L/s_GND: C2.2, J3.6, U2.8 (GND), U2.10 (TEST)
/Encoder_L/s_MISO: J3.5, U2.7 (MISO)
/Encoder_L/s_MOSI: J3.4, U2.4 (MOSI)
/Encoder_L/s_SCLK: J3.3, U2.12 (SCLK)
/Encoder_L/s_VDD: C2.1, J3.1, U2.13 (VDD)
/Encoder_R/s_CS: J5.2, U3.5 (~CS)
/Encoder_R/s_GND: C3.2, J5.6, U3.8 (GND), U3.10 (TEST)
/Encoder_R/s_MISO: J5.5, U3.7 (MISO)
/Encoder_R/s_MOSI: J5.4, U3.4 (MOSI)
/Encoder_R/s_SCLK: J5.3, U3.12 (SCLK)
/Encoder_R/s_VDD: C3.1, J5.1, U3.13 (VDD)
/Fan/fan_to_fet: J6.2, Q1.3 (D)
/Flash/BAT: C34.1, J17.6, U14.3 (V_{BAT})
/Flash/BAT_CH1: C32.1, J19.1, U12.3 (V_{BAT})
/Flash/BAT_CH2: C33.1, J20.1, U13.3 (V_{BAT})
/Flash/ESP32_BT: J17.2, SW4.1
/Flash/ESP32_EN: J17.3, SW3.1
/Flash/ESP32_RX: J17.5, U10.7 (TXD)
/Flash/ESP32_TX: J17.4, U10.10 (RXD)
/Flash/GND: C26.1, C27.2, C28.2, C29.2, C30.2, C31.2, C32.2, C33.2, C34.2, J17.1, J18.A1 (GND), J18.A12 (GND), J18.B1 (GND), J18.B12 (GND), J18.S1 (SHIELD), J19.2, J20.2, R17.2, R18.2, R22.2, R23.2, R24.2, SW3.2, SW4.2, U10.5 (GND), U11.2 (GND), U12.2 (V_{SS}), U13.2 (V_{SS}), U14.2 (V_{SS})
/Flash/USB_D+: J18.A6 (D+), J18.B6 (D+), U10.12 (USBDP)
/Flash/USB_D-: J18.A7 (D-), J18.B7 (D-), U10.1 (USBDM)
/Flash/VBUS: C27.1, C29.1, C30.1, C31.1, D11.2 (A), D12.2 (A), D13.2 (A), F1.2, U11.1 (VIN), U11.3 (~SHDN), U12.4 (V_{DD}), U13.4 (V_{DD}), U14.4 (V_{DD})
/Flash/VBUS_FUSE: F1.1, J18.A4 (VBUS), J18.A9 (VBUS), J18.B4 (VBUS), J18.B9 (VBUS)
/Flash/VCC: C26.2, C28.1, U10.2 (RESET#), U10.3 (3V3OUT), U10.4 (VCC), U10.9 (VCCIO), U11.5 (VOUT)
/IR_RCV_FL/LED_to_C: C9.1, D1.2 (A), R3.2
/IR_RCV_FL/LED_to_FET: D1.1 (K), Q2.3 (D)
/IR_RCV_FL/s_3.3V: C10.1, J8.1, Q3.1 (C), R3.1
/IR_RCV_FL/s_GND: C9.2, C10.2, J8.4, Q2.2 (S), R4.2
/IR_RCV_FL/s_IR_LED: J8.2, Q2.1 (G)
/IR_RCV_FL/s_IR_RCV: J8.3, Q3.2 (E), R4.1
/IR_RCV_FR/LED_to_C: C11.1, D2.2 (A), R5.2
/IR_RCV_FR/LED_to_FET: D2.1 (K), Q4.3 (D)
/IR_RCV_FR/s_3.3V: C12.1, J10.1, Q5.1 (C), R5.1
/IR_RCV_FR/s_GND: C11.2, C12.2, J10.4, Q4.2 (S), R6.2
/IR_RCV_FR/s_IR_LED: J10.2, Q4.1 (G)
/IR_RCV_FR/s_IR_RCV: J10.3, Q5.2 (E), R6.1
/IR_RCV_SL/LED_to_C: C13.1, D3.2 (A), R7.2
/IR_RCV_SL/LED_to_FET: D3.1 (K), Q6.3 (D)
/IR_RCV_SL/s_3.3V: C14.1, J12.1, Q7.1 (C), R7.1
/IR_RCV_SL/s_GND: C13.2, C14.2, J12.4, Q6.2 (S), R8.2
/IR_RCV_SL/s_IR_LED: J12.2, Q6.1 (G)
/IR_RCV_SL/s_IR_RCV: J12.3, Q7.2 (E), R8.1
/IR_RCV_SR/LED_to_C: C15.1, D4.2 (A), R9.2
/IR_RCV_SR/LED_to_FET: D4.1 (K), Q8.3 (D)
/IR_RCV_SR/s_3.3V: C16.1, J14.1, Q9.1 (C), R9.1
/IR_RCV_SR/s_GND: C15.2, C16.2, J14.4, Q8.2 (S), R10.2
/IR_RCV_SR/s_IR_LED: J14.2, Q8.1 (G)
/IR_RCV_SR/s_IR_RCV: J14.3, Q9.2 (E), R10.1
/Motor/MT_OUT_L1: J15.1, L1.1
/Motor/MT_OUT_L2: J15.2, U6.3 (AOUT2)
/Motor/MT_OUT_L_L: L1.2, U6.2 (AOUT1)
/Motor/MT_OUT_L_R: L2.2, U6.4 (BOUT1)
/Motor/MT_OUT_R1: J16.1, L2.1
/Motor/MT_OUT_R2: J16.2, U6.5 (BOUT2)
/ToF/s_3.3V: C23.1, C24.1, P2.1, R15.1, R16.1, U8.4 (GPIO0/CE), U8.8 (AVDD_VCSEL), U8.10 (AVDD)
/ToF/s_GND: C23.2, C24.2, P2.4, U8.9 (AVSS_VCSEL), U8.12 (AVSS)
/ToF/s_SCL: P2.3, R16.2, U8.5 (SCL)
/ToF/s_SDA: P2.2, R15.2, U8.6 (SDA)
BAT-VOL: C20.1, R11.2, R12.1, U1.11 (GPI35/VDET_2/ADC1_CH7)
BUTTON: J1.5, SW2.1, U1.23 (*GPIO0/ADC2_CH1/TOUCH1/CLK_OUT1/EMAC_TX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)
ENABLE: J1.4, R1.1, SW1.1, U1.9 (CHIP_PU)
FAN: Q1.1 (G), R2.1, U1.24 (GPIO4/ADC2_CH0/TOUCH0/HSPIHD/HS2_DATA1/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)
GND: BT1.2 (-), C1.1, C4.2, C5.2, C6.2, C7.2, C8.2, C17.2, C18.2, C19.2, C20.2, C21.2, C22.2, C25.2, D5.1 (K), D6.1 (K), J1.6, J2.6, J4.6, J7.4, J9.4, J11.4, J13.4, P1.4, Q1.2 (S), Q10.2 (S), R2.2, R12.2, SW1.2, SW2.2, U1.49 (GND), U4.6 (GND), U4.7 (RESV), U5.6 (GND), U5.7 (RESV), U6.6 (GND), U6.11 (MODE), U6.13 (GNDP), U7.2 (GND), U7.6 (GND), U7.9 (GND), U9.5 (VSS)
I2C-SCL: P1.3, U1.39 (GPIO22/VSPIWP/U0RTS/EMAC_TXD1), U9.6 (SCL)
I2C-SDA: P1.2, U1.42 (GPIO21/VSPIHD/EMAC_TX_EN), U9.7 (SDA)
MT-IN-L1: U1.12 (GPIO32/32K_XP/ADC1_CH4/TOUCH9), U6.10 (AIN1)
MT-IN-L2: U1.13 (GPIO33/32K_XN/ADC1_CH5/TOUCH8), U6.9 (AIN2)
MT-IN-R1: U1.38 (GPIO19/VSPIQ/U0CTS/EMAC_TXD0), U6.8 (BIN1)
MT-IN-R2: U1.27 (GPIO20), U6.7 (BIN2)
unnamed: D5.2 (A), R13.2
unnamed: D6.2 (A), R14.2
unnamed: D7.1 (K), RN1.5 (R4.2)
unnamed: D8.1 (K), RN1.6 (R3.2)
unnamed: D9.1 (K), RN1.7 (R2.2)
unnamed: D10.1 (K), RN1.8 (R1.2)
unnamed: D11.1 (K), R19.1
unnamed: D12.1 (K), R20.1
unnamed: D13.1 (K), R21.1
unnamed: J18.A5 (CC1), R18.1
unnamed: J18.B5 (CC2), R17.1
unnamed: LS1.2, Q10.3 (D)
unnamed: RN1.1 (R1.1), U9.4 (LED3)
unnamed: RN1.2 (R2.1), U9.3 (LED2)
unnamed: RN1.3 (R3.1), U9.2 (LED1)
unnamed: RN1.4 (R4.1), U9.1 (LED0)
unnamed: C6.1, U4.11 (REGOUT)
unnamed: C8.1, U5.11 (REGOUT)
unnamed: R22.1, U12.5 (PROG)
unnamed: R19.2, U12.1 (STAT)
unnamed: R23.1, U13.5 (PROG)
unnamed: R20.2, U13.1 (STAT)
unnamed: R24.1, U14.5 (PROG)
unnamed: R21.2, U14.1 (STAT)
PR-LED-FL: J7.2, U1.17 (GPIO14/ADC2_CH6/TOUCH6/MTMS/HSPI_CLK/HS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)
PR-LED-FR: J9.2, U1.21 (*GPIO15/ADC2_CH3/TOUCH3/MTDO/HSPICS0/HS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)
PR-LED-SL: J11.2, U1.18 (*GPIO12/ADC2_CH5/TOUCH5/MTDI/HSPIQ/HS2_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)
PR-LED-SR: J13.2, U1.20 (GPIO13/ADC2_CH4/TOUCH4/MTCK/HSPID/HS2_D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)
PR-RCV-FL: J7.3, U1.7 (GPI38/SENSOR_CAPN/ADC1_CH2)
PR-RCV-FR: J9.3, U1.8 (GPI39/SENSOR_VN/ADC1_CH3)
PR-RCV-SL: J11.3, U1.5 (GPI36/SENSOR_VP/ADC1_CH0)
PR-RCV-SR: J13.3, U1.6 (GPI37/SENSOR_CAPP/ADC1_CH1)
SPEAKER: Q10.1 (G), U1.14 (GPIO25/DAC_1/ADC2_CH8)
SPI-CS-ENC-L: J2.2, U1.32 (GPIO7/SD_DATA0/SPIQ/HS1_DATA0/U2RTS)
SPI-CS-ENC-R: J4.2, U1.33 (GPIO8/SD_DATA1/SPID/HS1_DATA1/U2CTS)
SPI-CS-IMU-L: U1.15 (GPIO26/DAC_2/ADC2_CH9), U4.12 (~CS)
SPI-CS-IMU-R: U1.16 (GPIO27/ADC2_CH7/TOUCH7), U5.12 (~CS)
SPI-MISO: J2.5, J4.5, U1.10 (GPI34/VDET_1/ADC1_CH6), U4.1 (SA0/SDO), U5.1 (SA0/SDO)
SPI-MOSI: J2.4, J4.4, U1.22 (*GPIO2/ADC2_CH2/TOUCH2/HSPIWP/HS2_DATA0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), U4.14 (SDA/SDI), U5.14 (SDA/SDI)
SPI-SCLK: J2.3, J4.3, U1.34 (*GPIO5/VSPICS0/HS1_DATA6/EMAC_RX_CLK), U4.13 (SCL/SCLK), U5.13 (SCL/SCLK)
UART-RX: J1.2, U1.40 (GPIO3/U0RXD/CLK_OUT2)
UART-TX: J1.3, U1.41 (GPIO1/U0TXD/CLK_OUT3/EMAC_RXD2)
