kerikun11/micromouse-kerise-v6/(commit log)

2023-12-30 設計中のファイルを追加
    [COM.kicad_sch, Encoder.kicad_sch, Fan.kicad_sch, Flash.kicad_sch, IMU.kicad_sch, IR_RCV.kicad_sch, KERISE.dsn, KERISE.kicad_pcb]
2023-12-30 自動配線完了
    [KERISE.dsn, KERISE.kicad_pcb]
2023-12-30 とりあえず配線完了
    [Flash.kicad_sch, KERISE.dsn, KERISE.kicad_pcb, temp-freerouting.dsn]
2023-12-30 Elecrowの指摘を修正
    [KERISE.kicad_pcb]
2023-12-30 1回目の基板修正
    [Flash.kicad_sch, IR_RCV.kicad_sch, KERISE.kicad_pcb]
2023-12-30 READMEを追加
